wykys/BNEZ-projekt/README.md

# Projekt BNEZ zdroj dvou napětí

Uin = 18V ÷ 32V
Uout1 = 9V 2,4A
Uout2 = 4,5V 0,5A

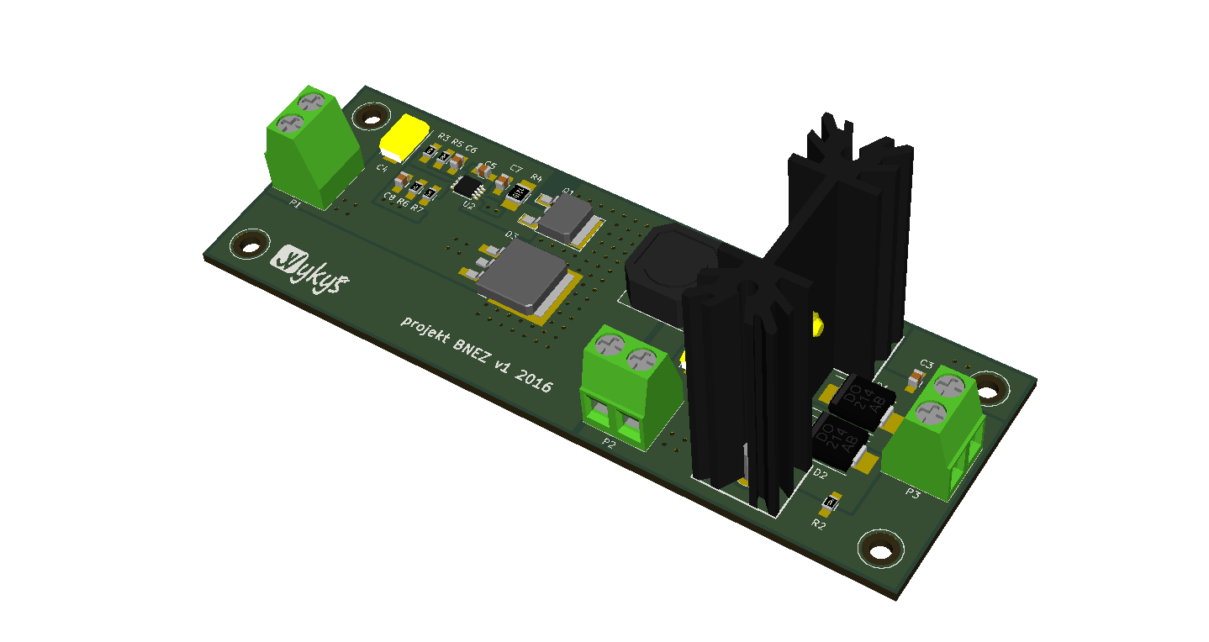
[picture p1: design/img/xvykyd06_zdroj_1.png]
demo
