wykys/BNEZ-projekt/dokumentace/realizace.tex

\clearpage
\section{Realizace napájecího zdroje}

\begin{figure}[H]
	\centering 	
	
	\caption{Plošný spoj vrstva součástek}	
\end{figure}

\begin{figure}[H]
	\centering 	
	
	\caption{Plošný spoj vrstva mědi}	
\end{figure}

\begin{figure}[H]
	\centering 	
	
	\caption{Osazovací výkres}	
\end{figure}

\begin{figure}[H]
	\centering 	
	
	\caption{Vrtací plán prokovené díry}	
\end{figure}

\begin{figure}[H]
	\centering 	
	
	\caption{Vrtací plán neprokovené díry}	
\end{figure}

\begin{table}[H]
	\caption{BOM rozpiska materiálu}
	\begin{figure}[H]
		\centering 	
		
	\end{figure}
\end{table}	

\newgeometry{left=1.25cm,bottom=1cm, top=2cm}
\begin{landscape}	
	\begin{figure}[h]
		\centering 	
		
		\caption{Schéma zapojení napájecího zdroje}	
	\end{figure}
\end{landscape}
\restoregeometry

\begin{figure}[H]
	\centering 	
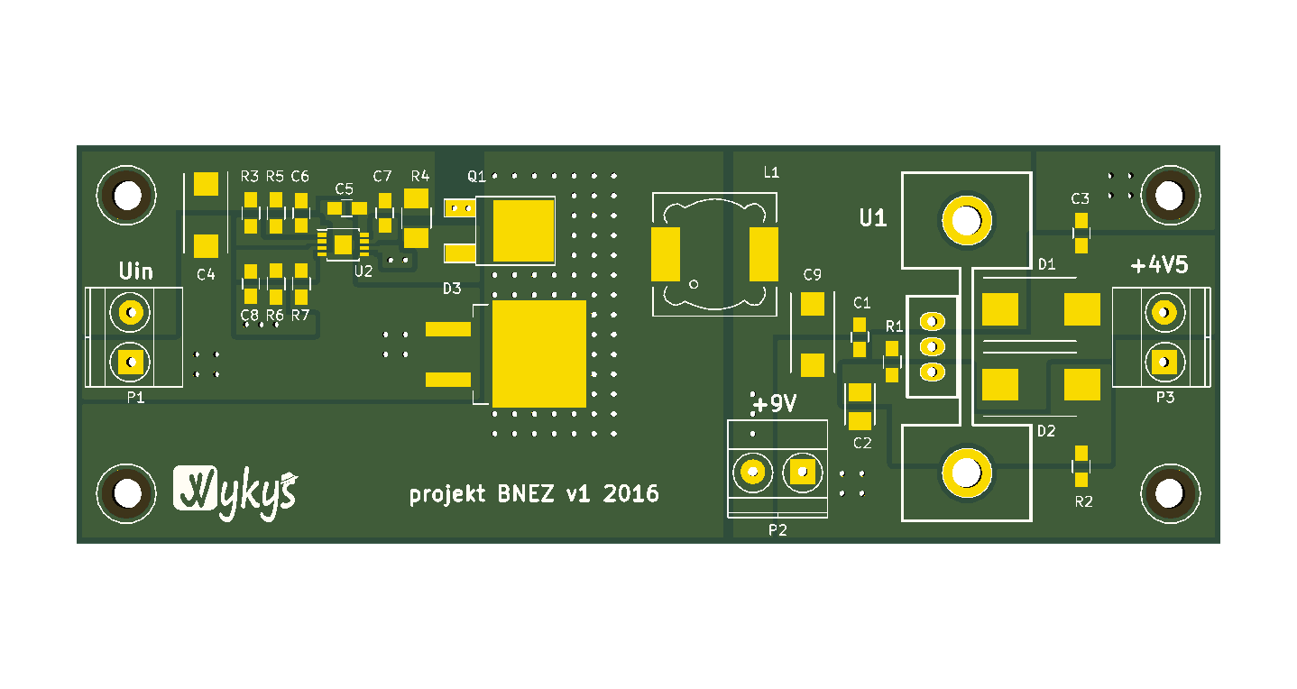
[picture p2: design/img/xvykyd06_zdroj_6.png]
	
	\caption{Plošný pohled na stranu součástek bez součástek}	
\end{figure}

\begin{figure}[H]
	\centering 	
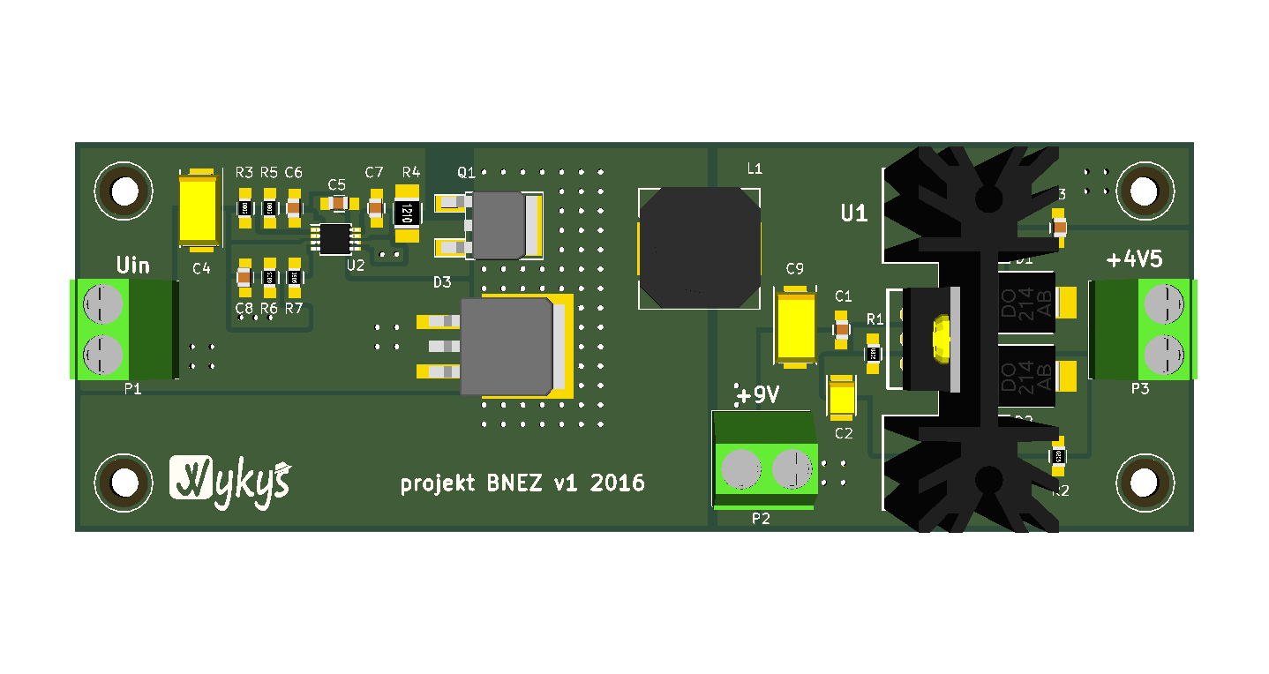
[picture p3: design/img/xvykyd06_zdroj_2.png]
	
	\caption{Plošný spoj pohled na stranu součástek}	
\end{figure}

\begin{figure}[H]
	\centering 	
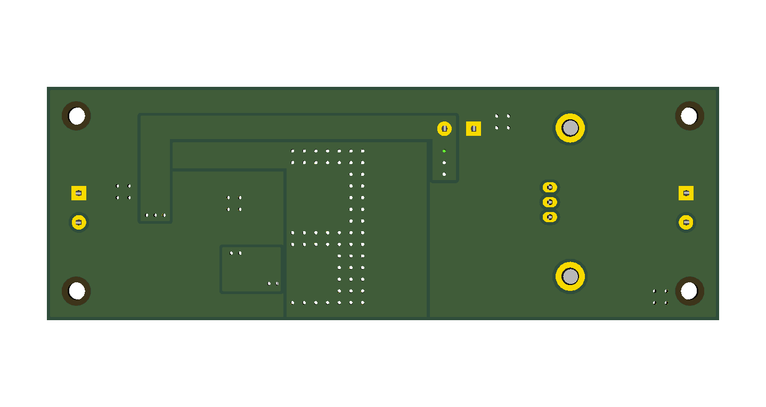
[picture p4: design/img/xvykyd06_zdroj_5.png]
	
	\caption{Plošný spoj pohled na stranu spojů}	
\end{figure}

\begin{figure}[H]
	\centering 	
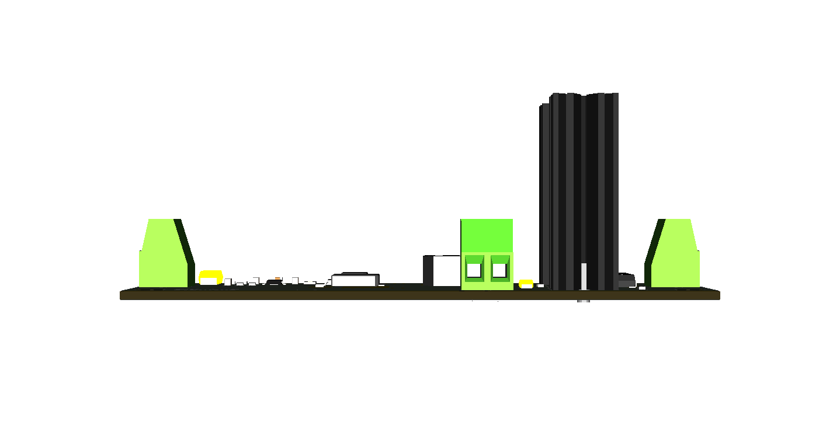
[picture p5: design/img/xvykyd06_zdroj_3.png]
	
	\caption{Napájecí zdroj pohled ze strany}	
\end{figure}

\begin{figure}[H]
	\centering 	
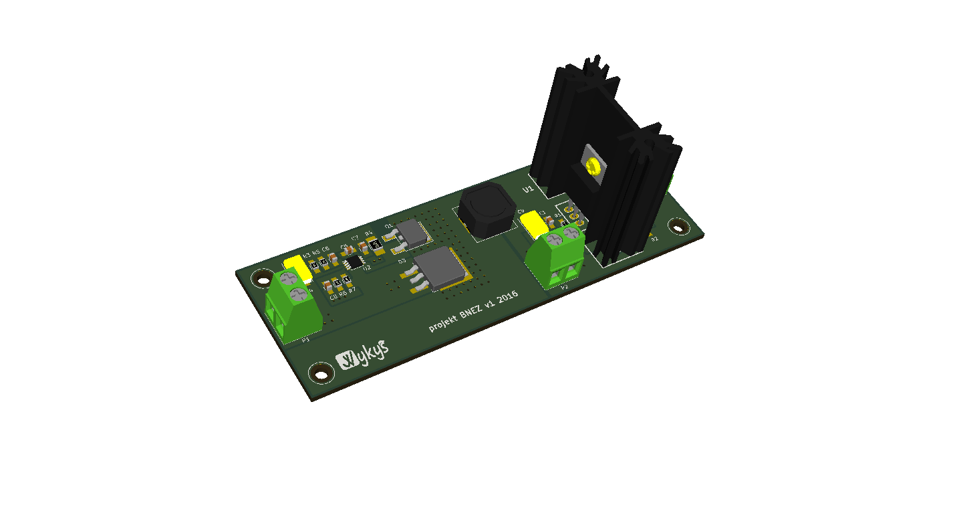
[picture p6: design/img/xvykyd06_zdroj_4.png]
	
	\caption{Napájecí zdroj pohled zepředu}	
\end{figure}

\begin{figure}[H]
	\centering 	
	
	\caption{Napájecí zdroj pohled zezadu}	
\end{figure}

Gerber soubory jsou generovány na POOL servis gatema.
