wykys/BNEZ-projekt/dokumentace/dokumentace.pdf

Jan Vykydal

Napajen ´ | í Elektronickych Za ´ | rˇízení

projekt zdroj dvou napetˇ í

FEKT UREL

List: | 1/11

## 1 Zadání

Uin | = (18 ÷ 32) V
Uout1 | = 9 V
Iout1 | = 2, 4 A
Uout2 | = 5 V
Iout2 | = 0, 5 A

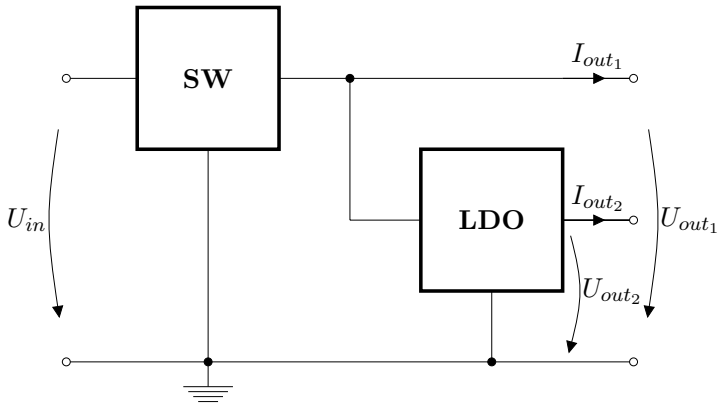
[picture p7: figure]
LDO; Iout2; Iout1; Uin; Uout1; Uout2

Obrázek 1: Blokové schéma zdroje

## 2 Vybrané integrované obvody

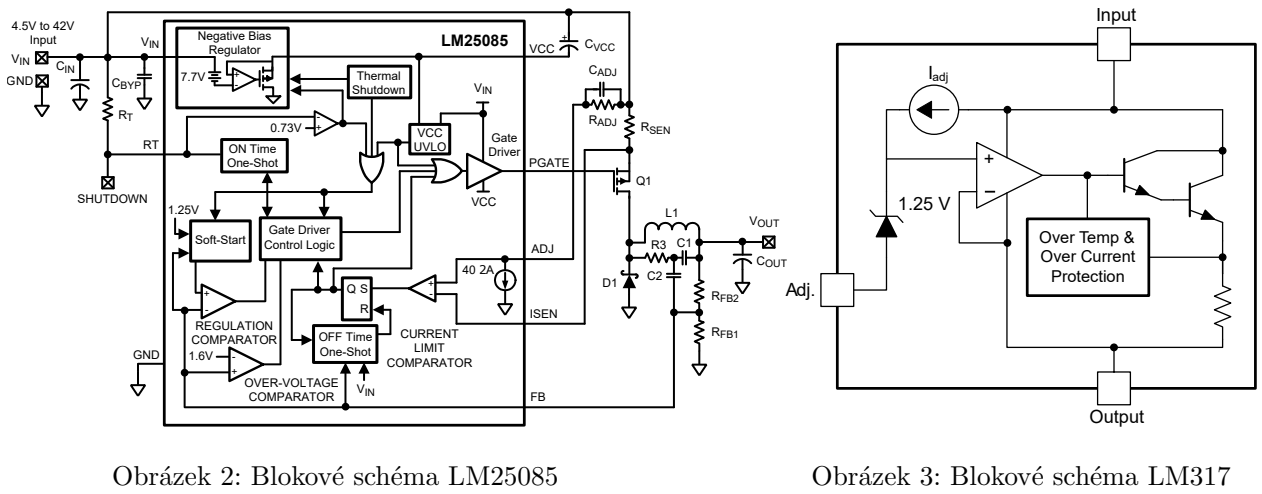
[picture p8: figure]
Negative Bias Regulator; Thermal Shutdown; ON Time One-Shot; Soft-Start; Gate Driver; Control Logic; VCC; UVLO; Gate; Driver; REGULATION COMPARATOR; OVER-VOLTAGE COMPARATOR; CURRENT LIMIT COMPARATOR; OFF Time One-Shot; PGATE; ISEN; GND; ADJ; 4.5V to 42V Input; VIN; SHUTDOWN; CVCC; CADJ; RADJ; RFB1; RFB2; CBYP; RSEN; VOUT; COUT; CIN; Obrázek 2: Blokové schéma LM25085; Over Temp & Over Current Protection; Input; Adj.; Output; Iadj; Obrázek 3: Blokové schéma LM317

LM25085 je regulátor PFET tranzistorů učený do spínaných snižujících měničů s vysokou účinností (buck). Naproti tomu LM317 je notoricky známý integrovaný obvod určený především jako lineární stabilizátor napětí, popřípadě drobnou úpravou okolních součástek a zapojení jako zdroj stabilního proudu.

## 3 Výpočty hodnot součástek pro LM25085 PFET kontrolér

VIN | = (18 ÷ 32) V
VIN | = 18 + 32
| 2 = 25 V
VOUT | = 9 V
IOUT | = Iout1 + Iout2
IOUT | = 2, 4 + 0, 5 .= 3 A
FSW | = 300 kHz
VRIP P LE | = 5 mVpp

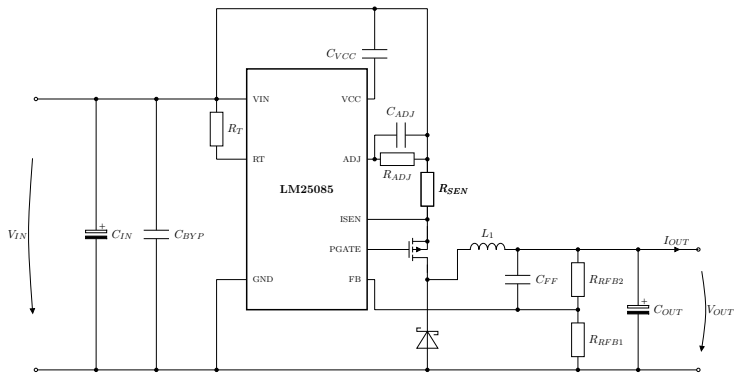
[picture p9: figure]
VIN; GND; VCC; ADJ; ISEN; PGATE; CIN; CBY P; CADJ; RADJ; RSEN; RRF B2; RRF B1; COUT; VOUT; IOUT

Obrázek 4: Snižující spínaný měnič

Výpočet střídy spínání:

D =

VOUT

VIN

=

tON

tON + tOF F

= tON · FS =

9
18

= 0, 5

9
25

= 0, 36

9
32

.= 0, 28

Výpočet doby otevření PFETu:

tON =

D
FS

=

VOUT

VIN · FS

9
18 · 300 · 10³

.= 1, 667 µs

9
25 · 300 · 10³

= 1, 2 µs

9
32 · 300 · 10³

= 937, 5 ns

Výpočet děliče zpětné vazby: RF B1 zvolím 1 kΩ

RF B2 =

VOUT
1, 25

− 1

- RF B1 =
9
1, 25

− 1

- 10³ = 6, 2 kΩ

Výpočet výstupního napětí:

VOUT = 1, 25 ·

RF B1 + RF B2

RF B1

= 1, 25 ·
1 +

RF B2

RF B1

= 1, 25 ·
1 +

6, 2
1
= 9 V

Výpočet kondenzátoru zpětné vazby:

CF F =

3 · Ton(max)

RBF1 · RBF2

RBF1 + RBF2

=

3 · 1, 667 · 10⁻⁶
1 · 10³
- 6, 2 · 10³
1 · 10³ + 6, 2 · 10³

= 5, 8 nF .= 6, 8 nF

Velikost rezistoru RT nastavuje spínací frekvenci: RT je v kΩ

RT =

VOUT · (VIN − 1, 56)
1, 45 · 10⁻⁷ · VIN · FS

−

tD · (VIN − 1, 56)
1, 45 · 10⁻⁷

− 1, 4

RT =

9 · (25 − 1, 56)
1, 45 · 10⁻⁷ · 25 · 300 · 10³

−

tD · (25 − 1, 56)
1, 45 · 10⁻⁷

− 1, 4 = 193, 016 kΩ .= 180 kΩ

Výpočet vyhlazovací cívky:

L1 =

tON(min)

·

VIN(max) − VOUT

0, 2 · IOUT

=

937, 5 · 10⁻⁹
- (32 − 9)
0, 2 · 3

.= 36 µH

Vzhledem k toleranci nominální hodnoty vyráběných cívek zvolím cívku 47 µH abych měl rezervu, pokud bude hodnota cívka v dolní části tolerančního pásma.

Výpočet vyhlazovacího kondenzátoru:

COUT =

0, 2 · IOUT

8 · FS · VRIP P LE

=

0, 2 · 3
8 · 300 · 10³ · 5 · 10⁻³

= 50 µF .= 68 µF

Vzhledem k tomu, že tento kondenzátor je na výstupu spínaného měniče kde se výstupní napětí pohybuje okolo 9 V , tak tento kondenzátor by měl být dimenzován minimálně na 16 V pro jistotu na 20 V .

Výpočet vstupního kondenzátoru:

CIN + CBY P =

IOUT · tON(max)
∆V | =

3 · 1, 667 · 10⁻⁶

0, 5

.= 10 µF

CBY P zvolím podle doporučení datasheetu jako 1 µF a CIN zvolím jako 10 µF na 50 V , protože vstupní napětí může být až 32 V .

Výpočet zvlnění proudu:

∆I =

tON(min)

·

VIN(max) − VOUT

L1

=

937, 5 · 10⁻⁹
- (32 − 9)
47 · 10⁻⁶

.= 459 mA

Velikost minimální hodnoty proudové limitace:

ICL(min) = IOUT +

∆I
2

= 3 +

0, 459
2

.= 3, 25 A

Výpočet minimálního proudového limitu se započítanou chybou offsetu komparátoru:

ICL(min)offset

= ICL(min) +

9 · 10⁻³

RSEN

= 3, 25 +

9 · 10⁻³
10 · 10⁻³

= 4, 15 A

Výpočet rezistoru RADJ :

RADJ =

ICL(min)offset

- RSEN

IADJ(min)

=

4, 15 · 10 · 10⁻³
32 · 10⁻⁶

= 1297 Ω

.= 1, 5 kΩ

CADJ = 1 nF hodnota podle doporučení v datasheetu, filtruje šum s ADJ pinu, zabraňuje nechtěnému sepnutí komparátoru.

Velikost rezistoru RSEN výrobce doporučuje 10 mΩ, výkonová ztráta na rezistoru je:

PRSEN = I

2
CL(min)
- RSEN = 3, 25²
- 10 · 10⁻³ .= 106 mW

Podle toho je důležité zvolit pouzdro, které snese takovéto zatížení. Vypočítané zatížení by snesl rezistor v pouzdru 0805, který vydrží 125 mW či pouzdro 1206 které vydrží do 250 mW, pro jistotu, ale volím pouzdro 1210, které vydrží výkon až 500 mW tím zajistím že součástka nebude na pokraji svých možností a bude mít dostatečnou životnost.

Hodnota kondenzátoru CV CC je dle doporučení datasheetu 470 nF.

## 4 Výpočty hodnot součástek pro lineární stabilizátor s LM317

Vi | = 9 V
Vo | = 4, 5 V
Io | = 0, 5 A
VREF | = 1, 25 V
IADJ | = 50 µA

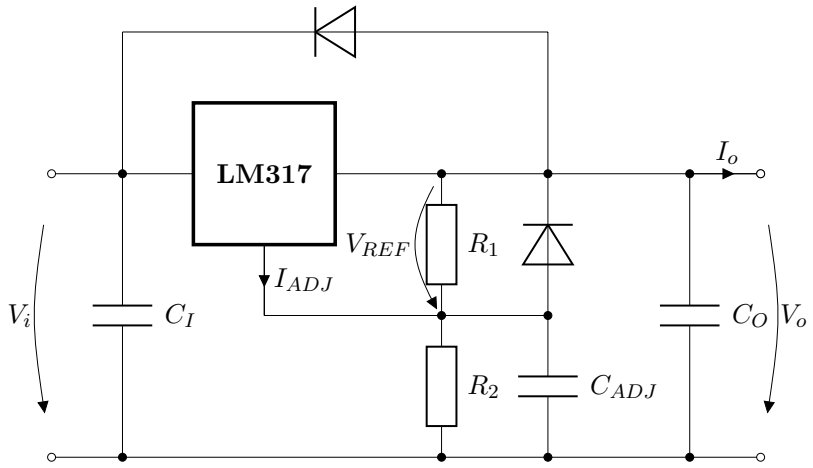
[picture p10: figure]
IADJ; VREF; CADJ

Obrázek 5: Lineární stabilizátor

Výpočet zpětnovazebního děliče:

R2 =

Vo − VREF

VREF
R1

+ IADJ

=

4, 5 − 1, 25
1, 25
R1

+ 50 · 10⁻⁶

K výpočtu nejpřesnější kombinace rezistorů R1 a R2 jsem napsal skript LM317.py, který vypočítá pro řady E3 ÷ E192 nejvhodnější kombinace rezistorů. Výsledek skriptu pro Vo = 4, 5 V je uveden v tabulce.

Tabulka č. 1: Hodnoty zpětnovazebného děliče pro LM317

řada | R [Ω] | R [Ω] | Vo [V ]
E3 | 100 | 220 | 4,0110
E6 | 680 | 1500 | 4,0824
E12 | 470 | 1200 | 4,5015
E24 | 510 | 1300 | 4,5013
E48 | 953 | 2370 | 4,4771
E96 | 562 | 1430 | 4,5021
E192 | 229 | 590 | 4,5000

Výpočet výstupního napětí:

Vo = VREF ·

1 +

R2
R1
+ IADJ · R2 = 1, 25 ·
1 +

590

229
+ 50 · 10⁻⁶
- 590 .= 4, 5 V

Vstupní a výstupní kondenzátor mají hodnotu podle doporučení datasheetu a to: Ci = 100 nF a Co = 1 µF. Na Co je možné ještě paralelně přiletovat CBY P ASS v pouzdru 0805 pro přemostění vysokofrekvenčního rušení. Kondenzátor pro stabilizaci napět’ové reference má také hodnotu dle doporučení výrobce CADJ = 10 µF.

## 5 Výpočty chlazení a výkonových ztrát

Výpočet výkonové ztráty na LM317:

PLM317 = (Vi − Vo) · Io = (9 − 4, 5) · 0, 5 = 2, 25 W

Výpočet výkonové ztráty na schottkyho diodě:

PD = VF · IOUT ·

1 − D(min)

= 3 · 0, 455 · (1 − 0, 28) .= 962 mW

Výpočet výkonové ztráty na PFETu:

PP F ET = VIN(max)

- (QG · FS + IIN ) = 32 · (24 · 10⁻⁹
- 300 · 10³ + 1, 3 · 10⁻³
) = 272 mW

Výpočet celkového tepelného odporu chlazení LM317:

Rthsys(LM317) =

ϑj(max) − ϑa

PLM317

=

150 − 80
2, 25

.= 32 KW⁻¹

Výpočet celkového tepelného odporu chlazení schottkyho diody:

Rthsys(D) =

ϑj(max) − ϑa

PD

=

150 − 80
0, 962

.= 73 KW⁻¹

Výpočet celkového tepelného odporu chlazení PFETu:

Rthsys(P F ET ) =

ϑj(max) − ϑa

PP F ET

=

175 − 80
0, 272

.= 345 KW⁻¹

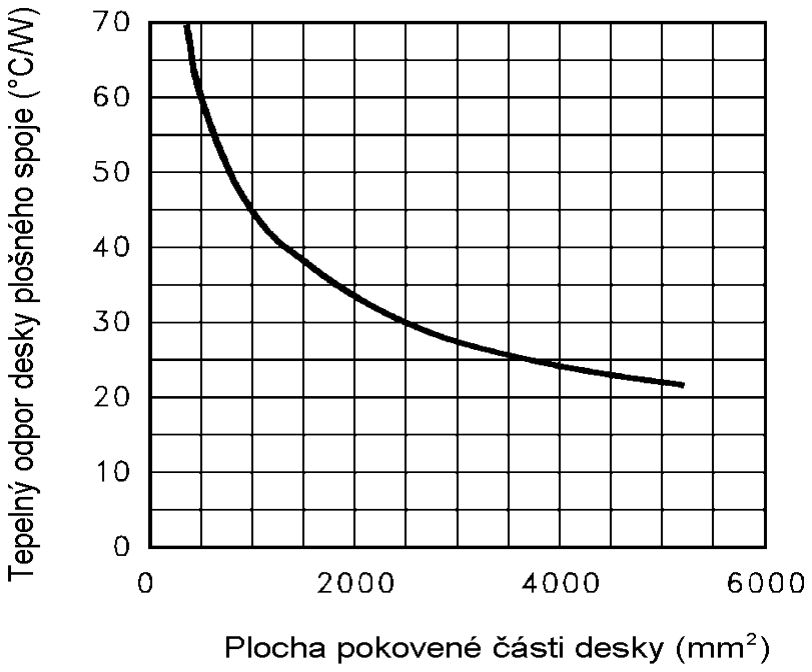
[picture p11: figure]

Obrázek 6: Graf závislosti tepelného odporu plošného spoje na jeho ploše

Z grafů vyplývá, že shottkyho diodu a PFET nebude problém uchladit plošným spojem, pro LM317 ale vychází plocha mědi na můj vkus příliš veliká cca 7 cm·7 cm a tak zvolím klasické chlazení hliníkovým profilem. Vybral jsem chladič s tepelným odporem 11 KW⁻¹
, takže teplota křemíkového čipu LM317 by měla být nižší, než teplota maximální na kterou jsem počítal celkový tepelný odpor.

## 6 Realizace napájecího zdroje

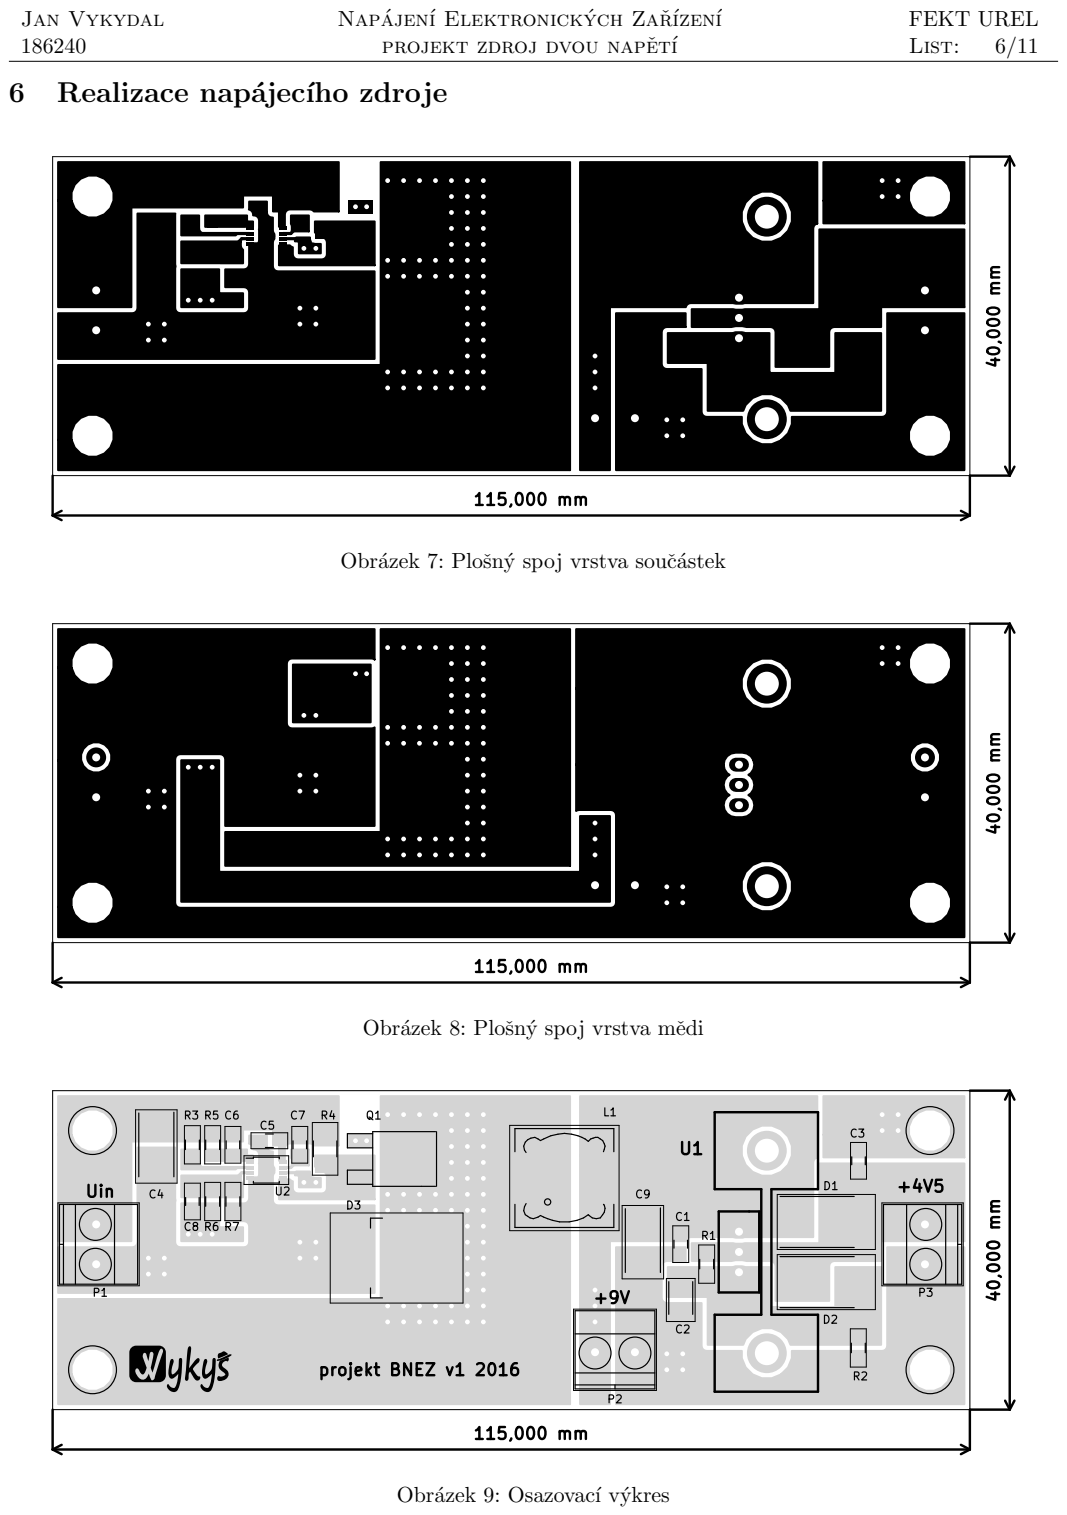
[picture p12: page 6]

Obrázek 7: Plošný spoj vrstva součástek

Obrázek 8: Plošný spoj vrstva mědi

Obrázek 9: Osazovací výkres

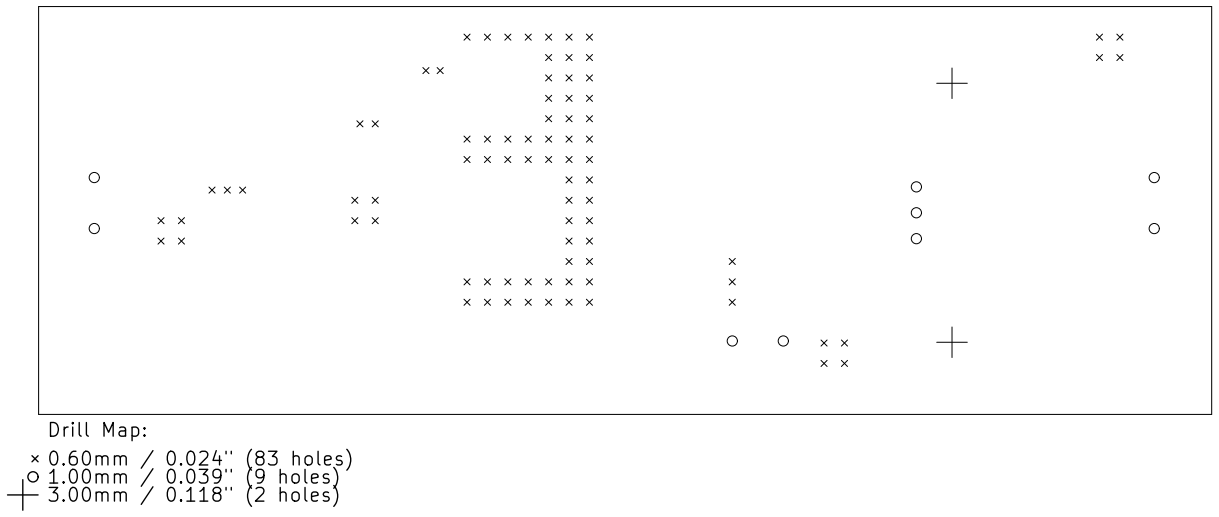
[picture p13: figure]

Obrázek 10: Vrtací plán prokovené díry

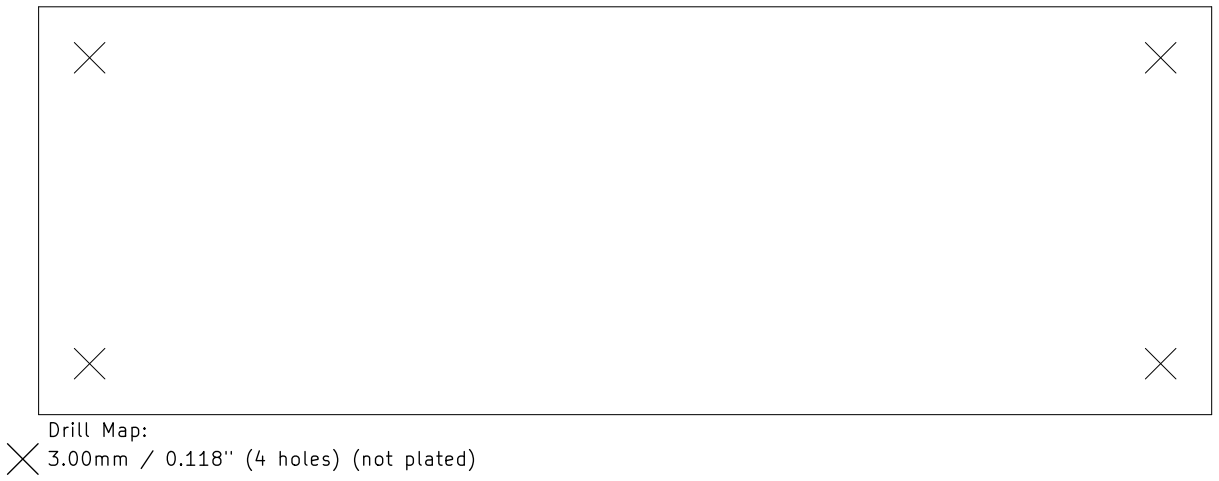
[picture p14: figure]

Obrázek 11: Vrtací plán neprokovené díry

Tabulka č. 2: BOM rozpiska materiálu

ref | hodnota | footprint | cena | link | datasheet
C1 | 100n | 0805 | 1,0000 | standatd 10%
C2 | 10u/20V | Tantal_SizeB | 12,4510 | http://cz.farnell.com/kemet/t491b106k020at/cap-tant-10uf-20v-case-b/dp/1457437 | http://www.farnell.com/datasheets/2121504.pdf
C3 | 1u | 0805 | 20,0000 | standatd 10%
C4 | 10u/50V | Tantal_SizeD | 62,3920 | http://cz.farnell.com/kemet/t491d106k050at/cap-tant-10uf-50v-case-d/dp/1692396RL | http://www.farnell.com/datasheets/2122222.pdf
C5 | 1u | 0805 | 20,0000 | standatd 10%
C6 | 1n | 0805 | 1,0000 | standatd 10%
C7 | 470n | 0805 | 1,0000 | standatd 10%
C8 | 6n8 | 0805 | 1,0000 | standatd 10%
C9 | 68u/20V | Tantal_SizeD | 40,8580 | http://cz.farnell.com/kemet/t491d686k020at/cap-tant-68uf-20v-case-d/dp/2283592RL | http://www.farnell.com/datasheets/2121528.pdf
D1 | BYG10D-E3/TR | DO-214AC | 6,4320 | http://cz.farnell.com/vishay/byg10d-e3-tr/diode-standard-1-5-a-do-214/dp/1612314 | http://www.farnell.com/datasheets/2046084.pdf
D2 | BYG10D-E3/TR | DO-214AC | 6,4320 | http://cz.farnell.com/vishay/byg10d-e3-tr/diode-standard-1-5-a-do-214/dp/1612314 | http://www.farnell.com/datasheets/2046084.pdf
D3 | STPS20M100S | TO-263 | 64,8760 | http://cz.farnell.com/stmicroelectronics/stps20m100sg-tr/diode-schottky-20a-100v-d2pak/dp/2325907 | http://www.farnell.com/datasheets/1716357.pdf
L1 | 47u | Choke_SMD_12x12mm_h6mm | 57,4230 | http://cz.farnell.com/bourns/srp1265a-470m/inductor-shielded-47uh-20-6-5a/dp/2434080 | http://www.farnell.com/datasheets/2059704.pdf
P1 | MA522-500M02 | TerminalBlock_Pheonix_MKDS1.5-2pol | 7,0440 | http://cz.farnell.com/multicomp/ma522-500m02/terminal-block-wire-to-brd-2pos/dp/2396252 | http://www.farnell.com/datasheets/2059704.pdf
P2 | MA522-500M02 | TerminalBlock_Pheonix_MKDS1.5-2pol | 7,0440 | http://cz.farnell.com/multicomp/ma522-500m02/terminal-block-wire-to-brd-2pos/dp/2396252 | http://www.farnell.com/datasheets/1706879.pdf
P3 | MA522-500M02 | TerminalBlock_Pheonix_MKDS1.5-2pol | 7,0440 | http://cz.farnell.com/multicomp/ma522-500m02/terminal-block-wire-to-brd-2pos/dp/2396252 | http://www.farnell.com/datasheets/1706879.pdf
Q1 | FDD5614P | TO-252 | 12,9200 | http://cz.farnell.com/fairchild-semiconductor/fdd5614p/mosfet-p-60v-15a-d-pak/dp/9846131 | http://www.farnell.com/datasheets/1706879.pdf
R1 | 510R | 0805 | 2,0000 | standatd 1%
R2 | 1k3 | 0805 | 2,0000 | standatd 1%
R3 | 180k | 0805 | 2,0000 | standatd 1%
R4 | R01 | 1210 | 8,0000 | standatd 1%
R5 | 1k5 | 0805 | 2,0000 | standatd 1%
R6 | 6k2 | 0805 | 2,0000 | standatd 1%
R7 | 1k | 0805 | 2,0000 | standatd 1%
U1 | LM317KCS | TO-220 | 16,0120 | http://cz.farnell.com/texas-instruments/lm317kcs/v-reg-37vin-1-5a-0-1-adj- 3to220/dp/2144307?ost=LM317KChttp://www.farnell.com/datasheets/1994326.pdf
U2 | LM25085MYE | MSOP | 60,7350 | http://cz.farnell.com/texas-instruments/lm25085mye/ic-sw-buck-controller-42v-8msoic/dp/1689555 | http://cz.farnell.com/texas-instruments/lm25085mye/ic-sw-buck-controller-42v-8msoic/dp/1689555
| chladič | na TO-220 | 48,0360 | http://cz.farnell.com/fischer-elektronik/sk-104-38-1-sts/heatsink-to220/dp/1892327 | http://www.farnell.com/datasheets/1332085.pdf
Celková cena: | 473,6990

# R4 R01 R³ 180k 470n C7 R5

# VCC GND

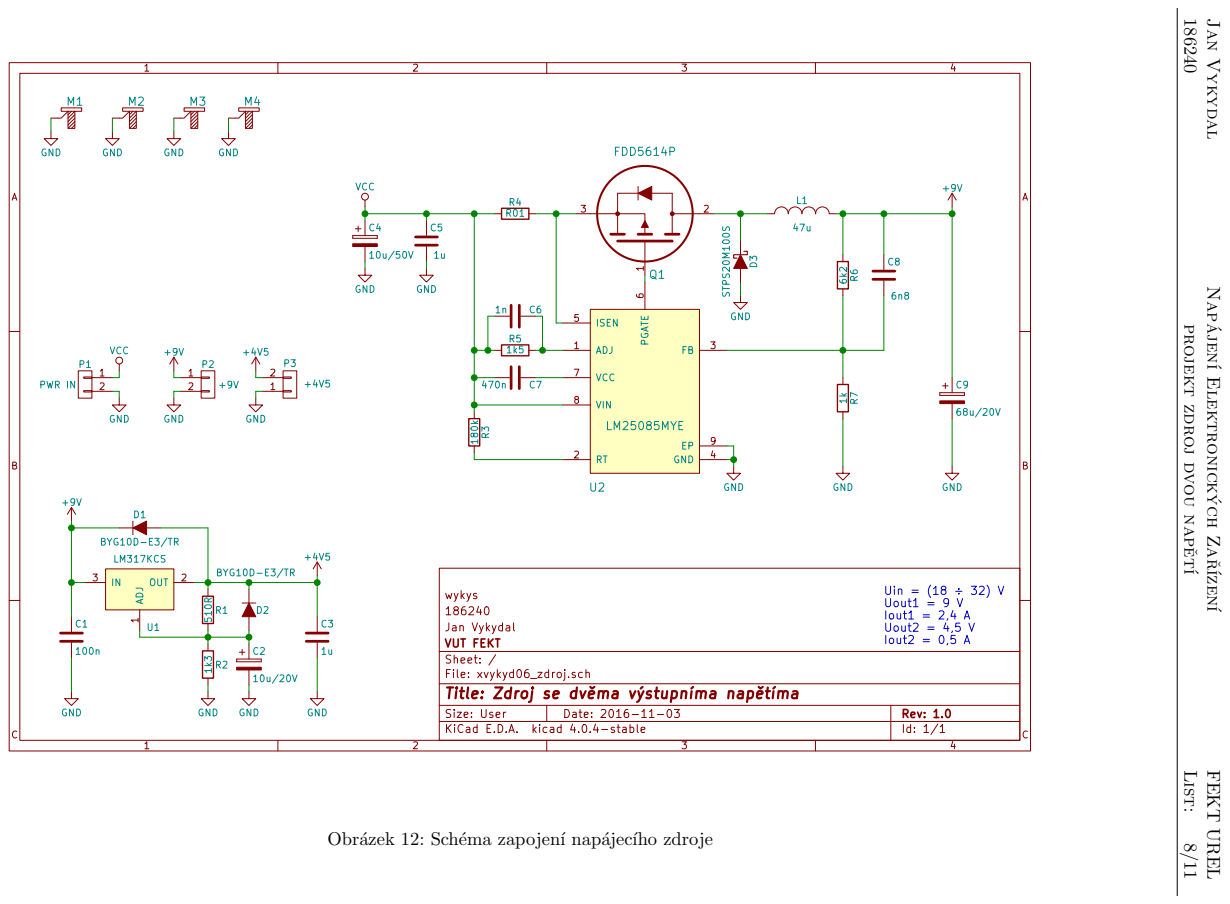
[picture p15: page 8]

Jan Vykydal Napajen ´ ı Elektronick ´ ych Za ´ rǐzen ´ í

projekt zdroj dvou napetˇ í List:

File: xvykyd06_zdroj.sch Sheet: / VUT FEKT

Id: 1/1 Title: Zdroj se dvma výstupníma naptíma

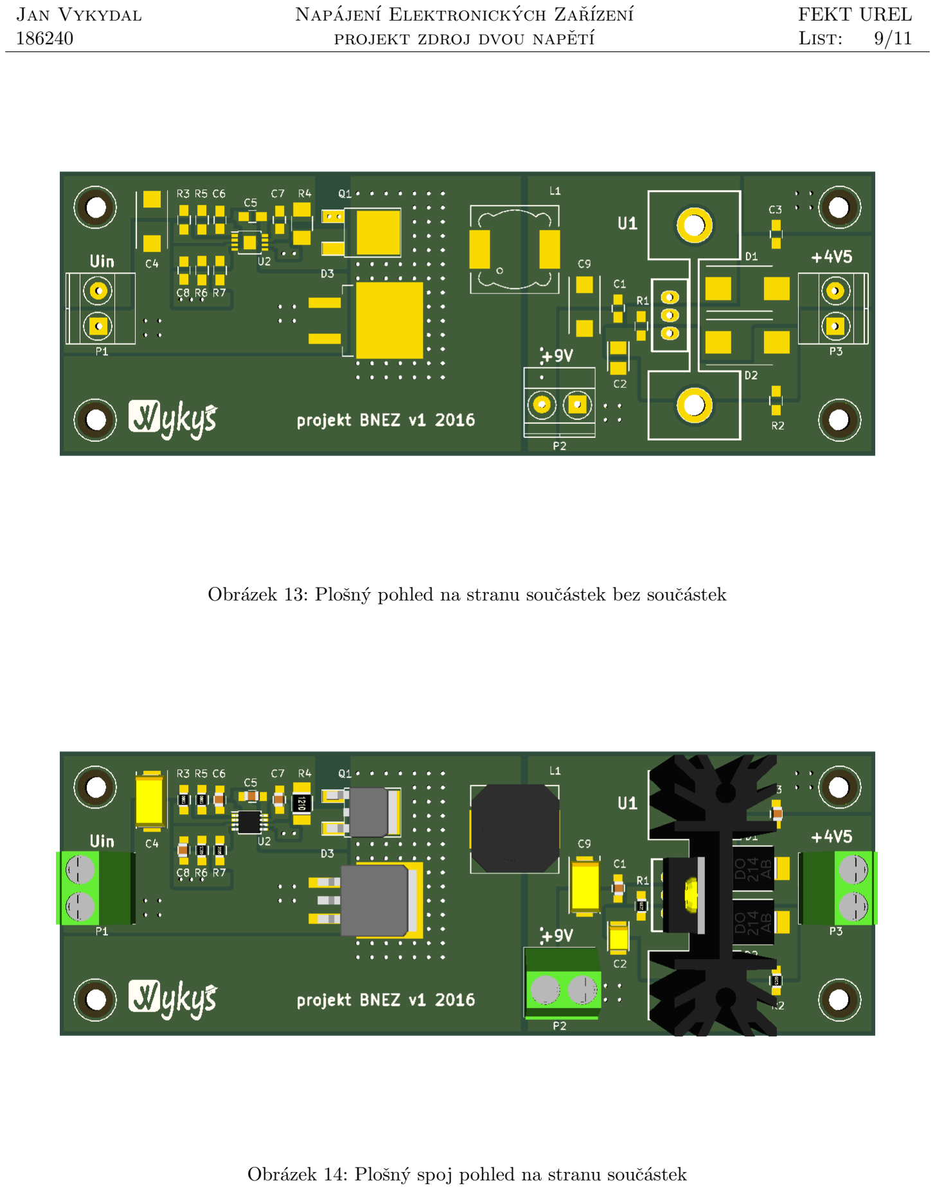
[picture p16: page 9]

Obrázek 13: Plošný pohled na stranu součástek bez součástek

Obrázek 14: Plošný spoj pohled na stranu součástek

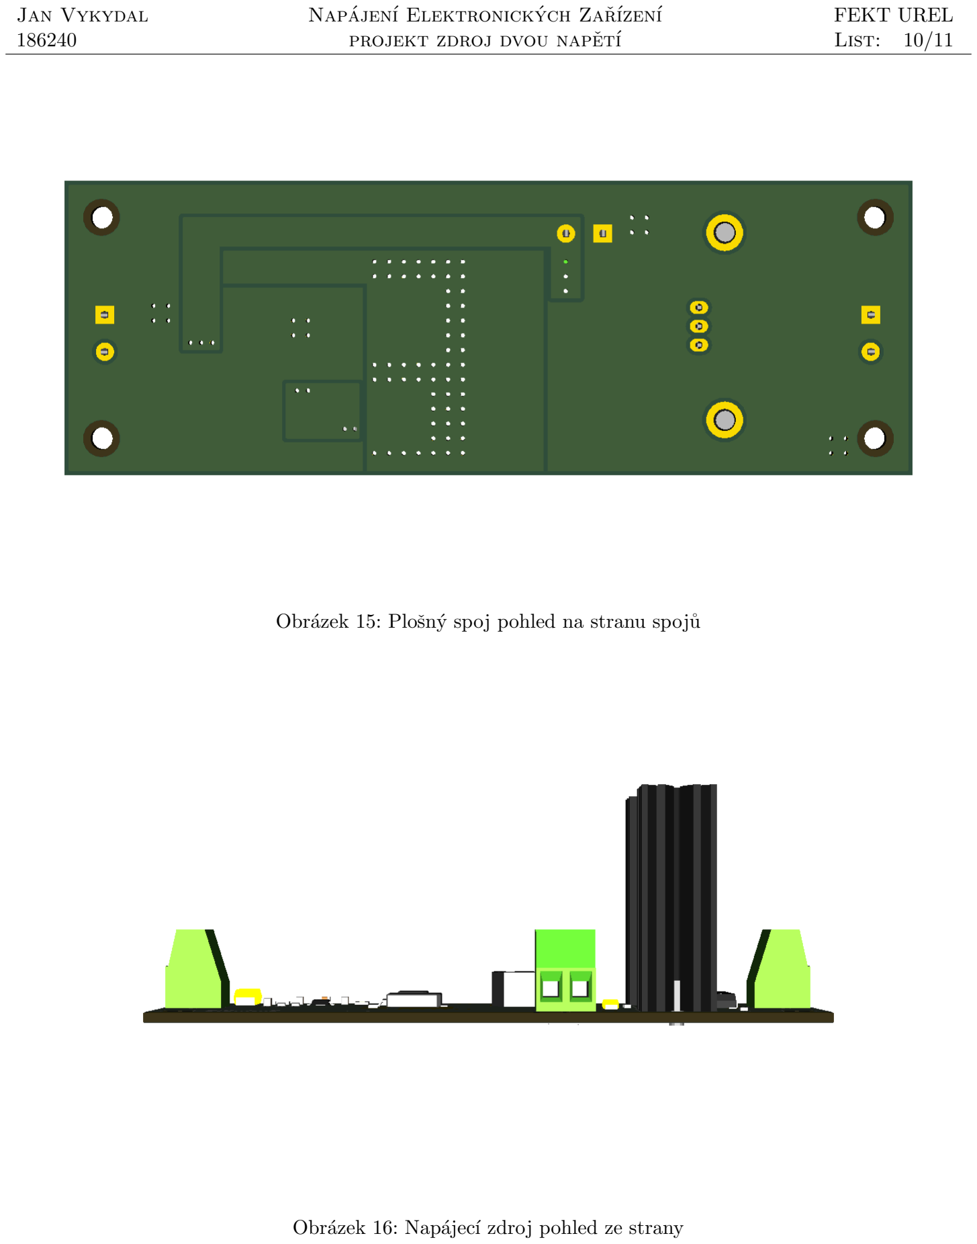
[picture p17: page 10]

Obrázek 15: Plošný spoj pohled na stranu spojů

Obrázek 16: Napájecí zdroj pohled ze strany

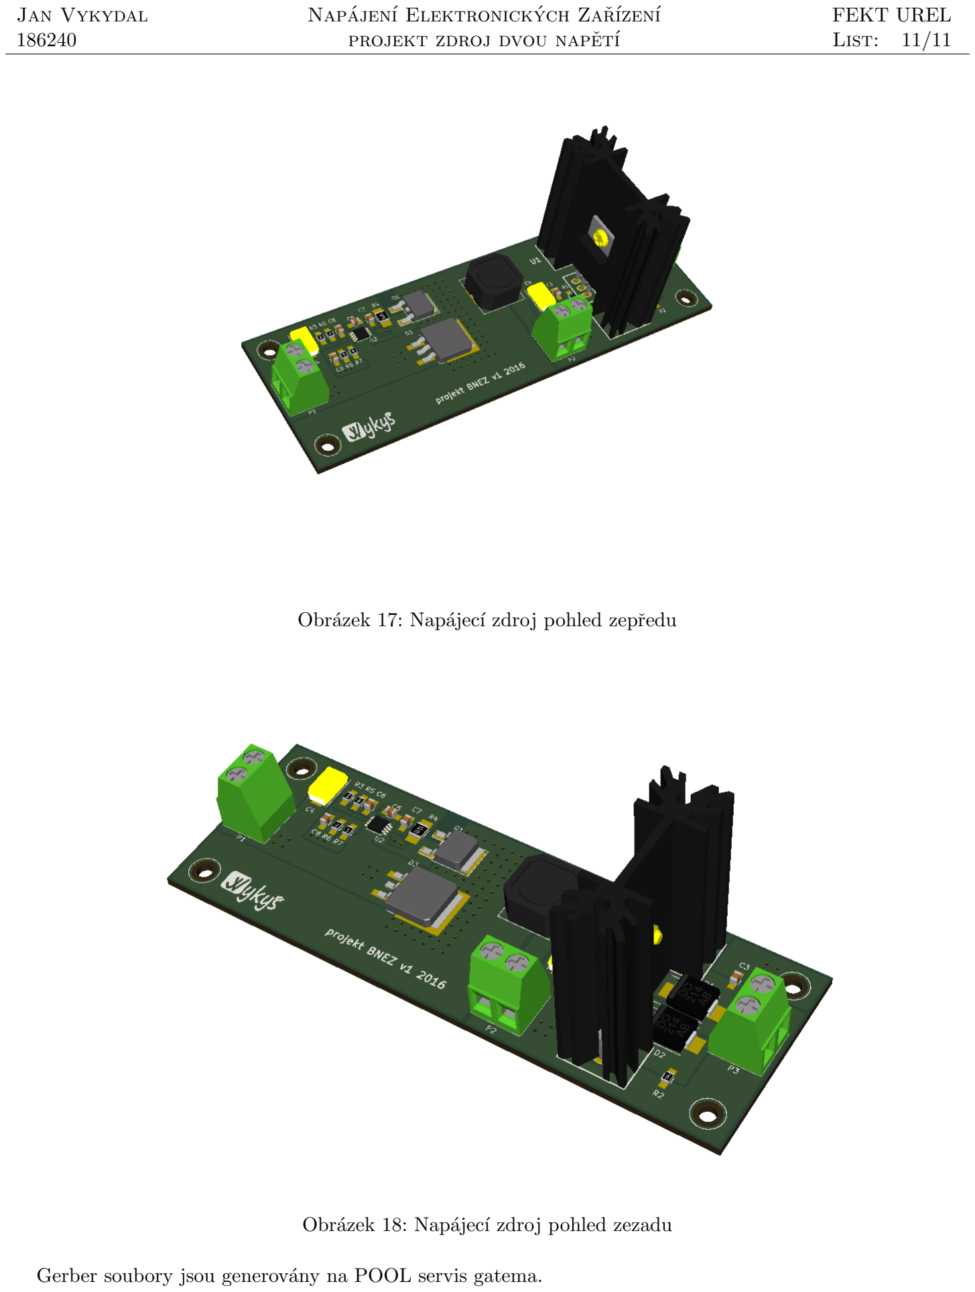
[picture p18: page 11]

Obrázek 17: Napájecí zdroj pohled zepředu

Obrázek 18: Napájecí zdroj pohled zezadu

Gerber soubory jsou generovány na POOL servis gatema.
