wykys/BNEZ-projekt/dokumentace/zadani.tex

\section{Zadání}

\begin{table}[H]
	\begin{center}

		\begin{tabular}{c | c}
			\begin{minipage}{0.3\textwidth}
				\begin{eqnarray}
					U_{in} &=& (18 \div 32)~V \nonumber\\\nonumber\\
					U_{out_1} &=& 9~V \nonumber\\
					I_{out_1} &=& 2,4~A \nonumber\\\nonumber\\
					U_{out_2} &=& 5~V \nonumber\\
					I_{out_2} &=& 0,5~A \nonumber
				\end{eqnarray}
			\end{minipage}

	&		
				
			\begin{minipage}{0.6\textwidth}
				\begin{figure}[H]
					\begin{center}
						\begin{circuitikz}
							%\draw[help lines, thick] (0,0) grid (10,8);	
							\draw (2,4) node[ic3pin] (ic1) {\textbf{SW}};
							\draw (6,2) node[ic3pin] (ic2) {\textbf{LDO}};			
							
							%(0,0) node[anchor=east] {Vstup}			
							\draw (0,0) to[short, o-o] (8,0);
							\draw (0,4) to[short, o-] (1,4);			
							\draw (3,4) to[short, -] (7,4);
							\draw (7,2) to[short, -o, i=$I_{out_2}$] (8,2);			
							\draw (4,4) to[short, *-] (4,2) to[short] (5,2);
							\draw (2,3) to[short, -*] (2,0);
							\draw (6,1) to[short, -*] (6,0);
							
							\draw (2,0) node[ground] {};
							
							\draw (7,4) to[short, -o, i=$I_{out_1}$] (8,4);
							\draw (0,4) to[open, v=$U_{in}$] (0,0);
							\draw (8.1,0) to[open, v<=$U_{out_1}$] (8.1,4);
							\draw (7,0) to[open, v<=$U_{out_2}$] (7,2);			

						\end{circuitikz}
					\end{center}
					\caption{Blokové schéma zdroje}
				\end{figure}
			\end{minipage}
		\end{tabular}
	\end{center}	
\end{table}
