wykys/BNEZ-projekt/dokumentace/img/DPS_odpor.pdf

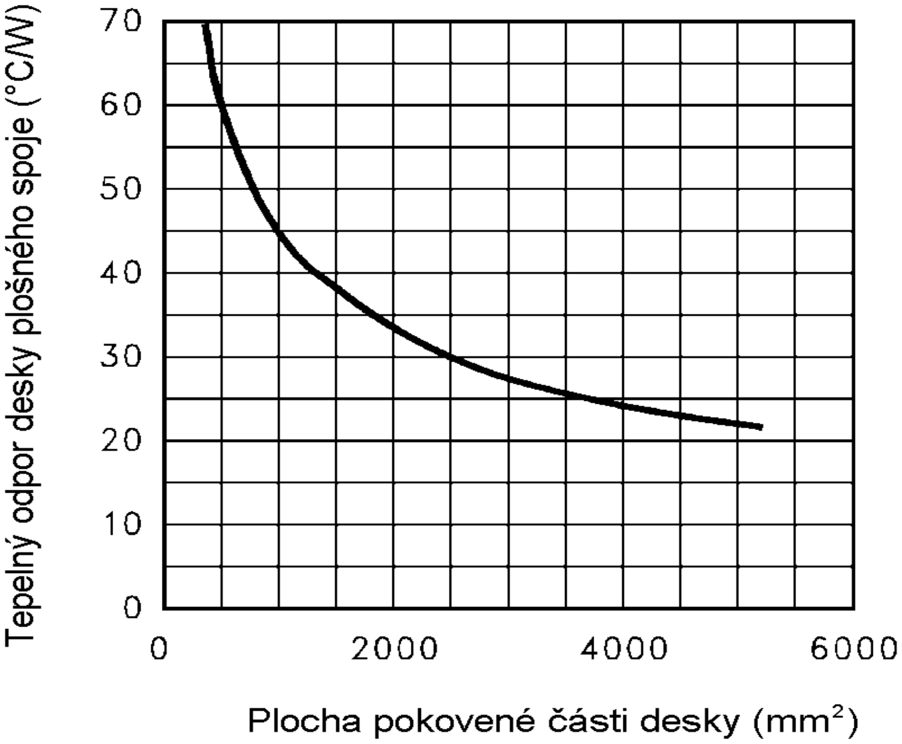
[picture p19: page 1]
