wykys/BNEZ-projekt/webench_design_4837964_17_571227985.pdf

## WEBENCH ® Design Report

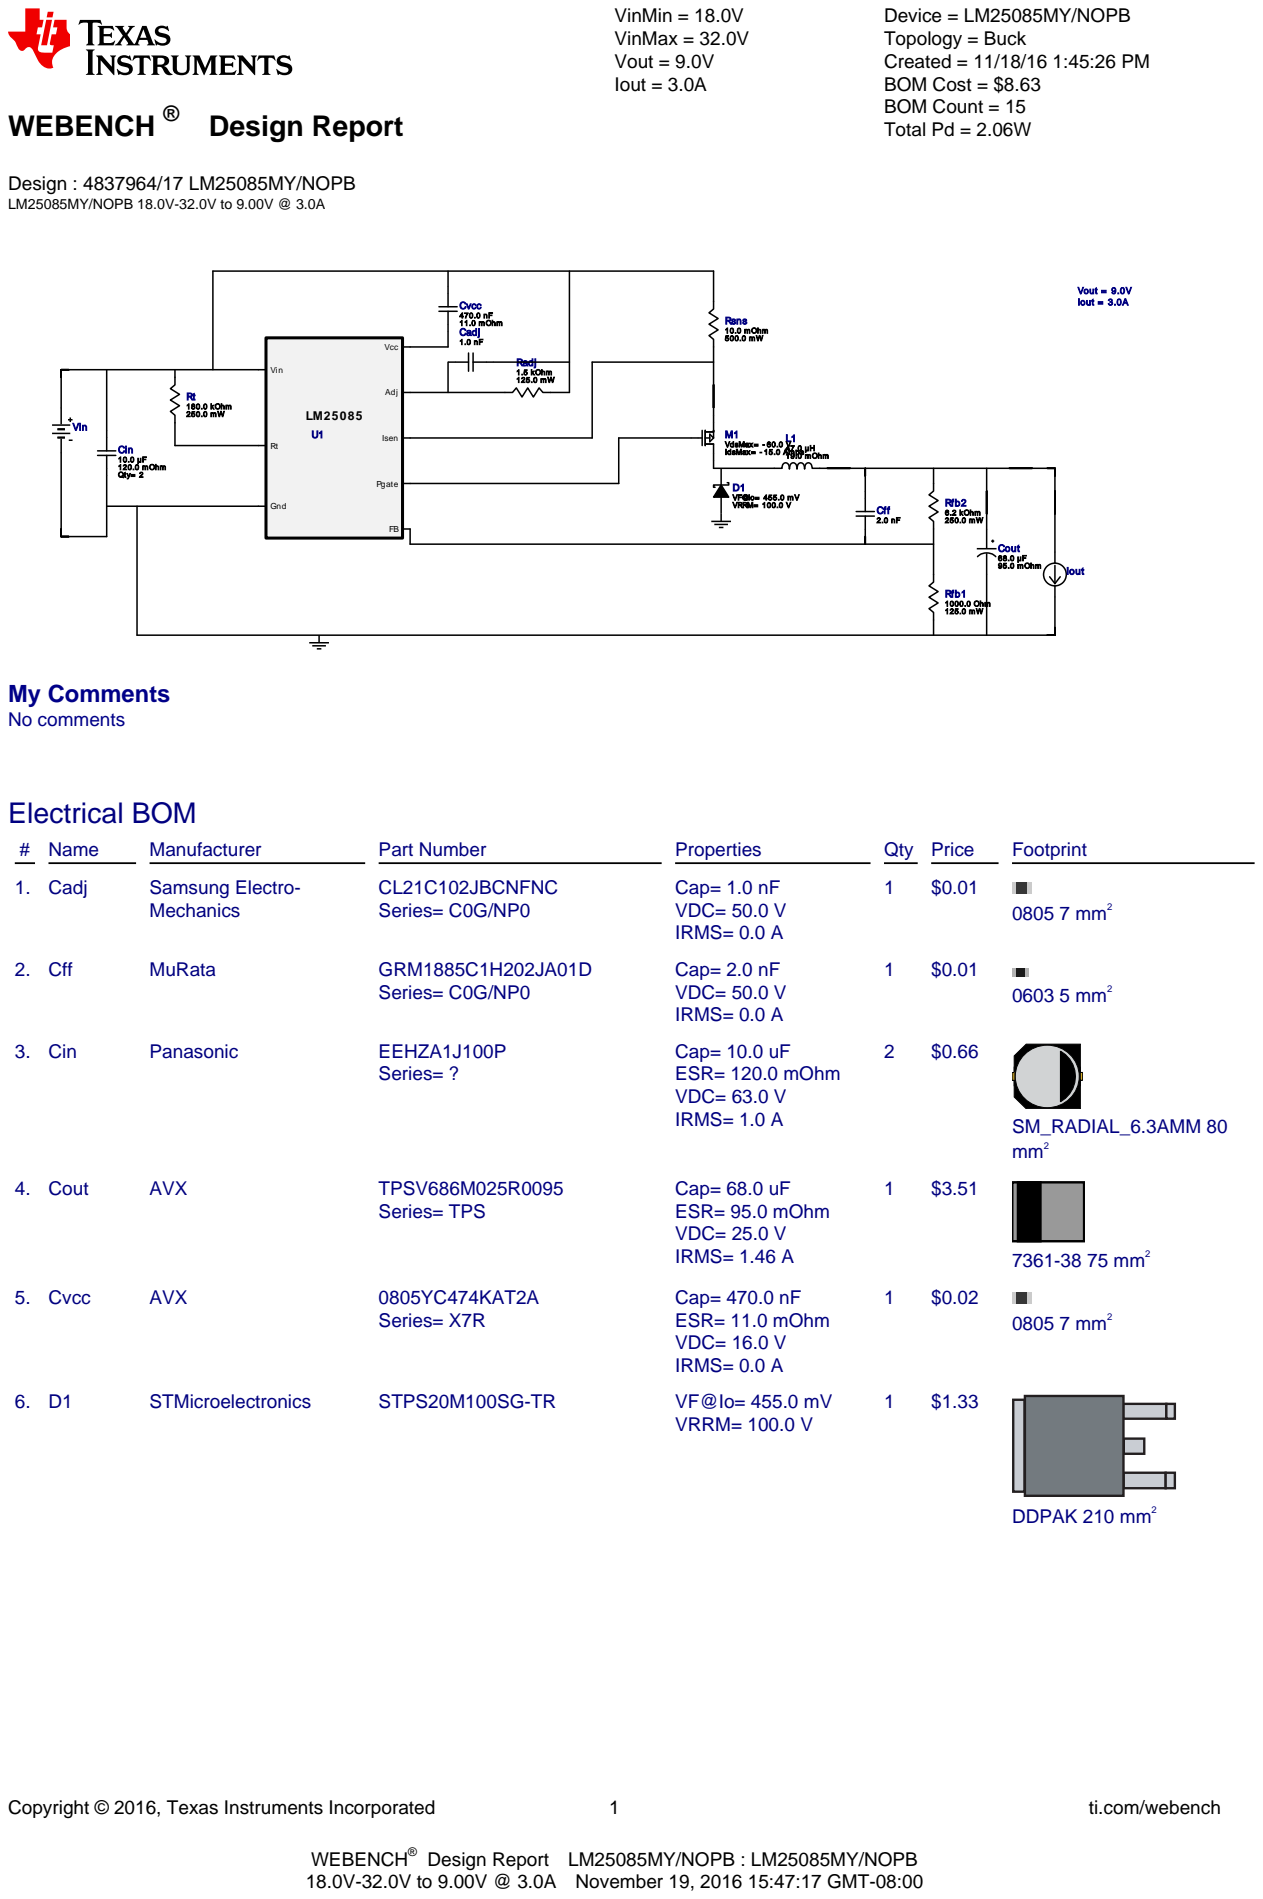
[picture p20: page 1]
Copyright © 2016, Texas Instruments Incorporated; ti.com/webench; Design : 4837964/17 LM25085MY/NOPB LM25085MY/NOPB 18.0V-32.0V to 9.00V @ 3.0A; VinMin = 18.0V VinMax = 32.0V Vout = 9.0V Iout = 3.0A; Device = LM25085MY/NOPB Topology = Buck Created = 11/18/16 1:45:26 PM BOM Cost = $8.63 BOM Count = 15 Total Pd = 2.06W; Cff 2.0 nF; Cadj 1.0 nF; Cin 10.0 µF 120.0 mOhm Qty= 2; Cout 68.0 µF; 95.0 mOhm; Cvcc 470.0 nF 11.0 mOhm; D1 VF@Io= 455.0 mV VRRM= 100.0 V; L1 47.0 µH 19.0 mOhm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

WEBENCH®
18.0V-32.0V to 9.00V @ 3.0A November 19, 2016 15:47:17 GMT-08:00

Design Report LM25085MY/NOPB : LM25085MY/NOPB

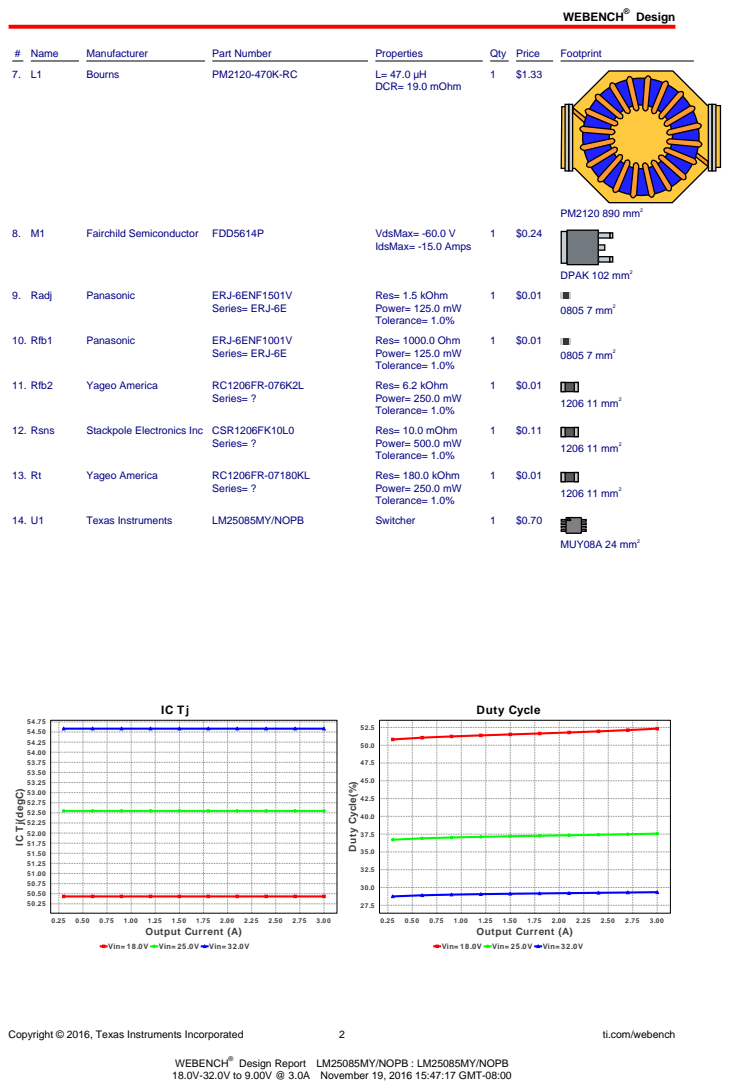
[picture p21: page 2]
Design; Copyright © 2016, Texas Instruments Incorporated; ti.com/webench; # Name; Manufacturer; Part Number; Properties; Qty Price; Footprint; Bourns; DCR= 19.0 mOhm; PM2120 890 mm²; Fairchild Semiconductor FDD5614P; VdsMax= -60.0 V; IdsMax= -15.0 Amps; DPAK 102 mm²; 9. Radj; Panasonic; ERJ-6ENF1501V; Series= ERJ-6E; Res= 1.5 kOhm Power= 125.0 mW Tolerance= 1.0%; 0805 7 mm²; 10. Rfb1; ERJ-6ENF1001V; Res= 1000.0 Ohm Power= 125.0 mW Tolerance= 1.0%; 11. Rfb2; Yageo America; Series= ?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

IC Tj(degC)

Vin= 18.0V Vin= 25.0V Vin= 32.0V

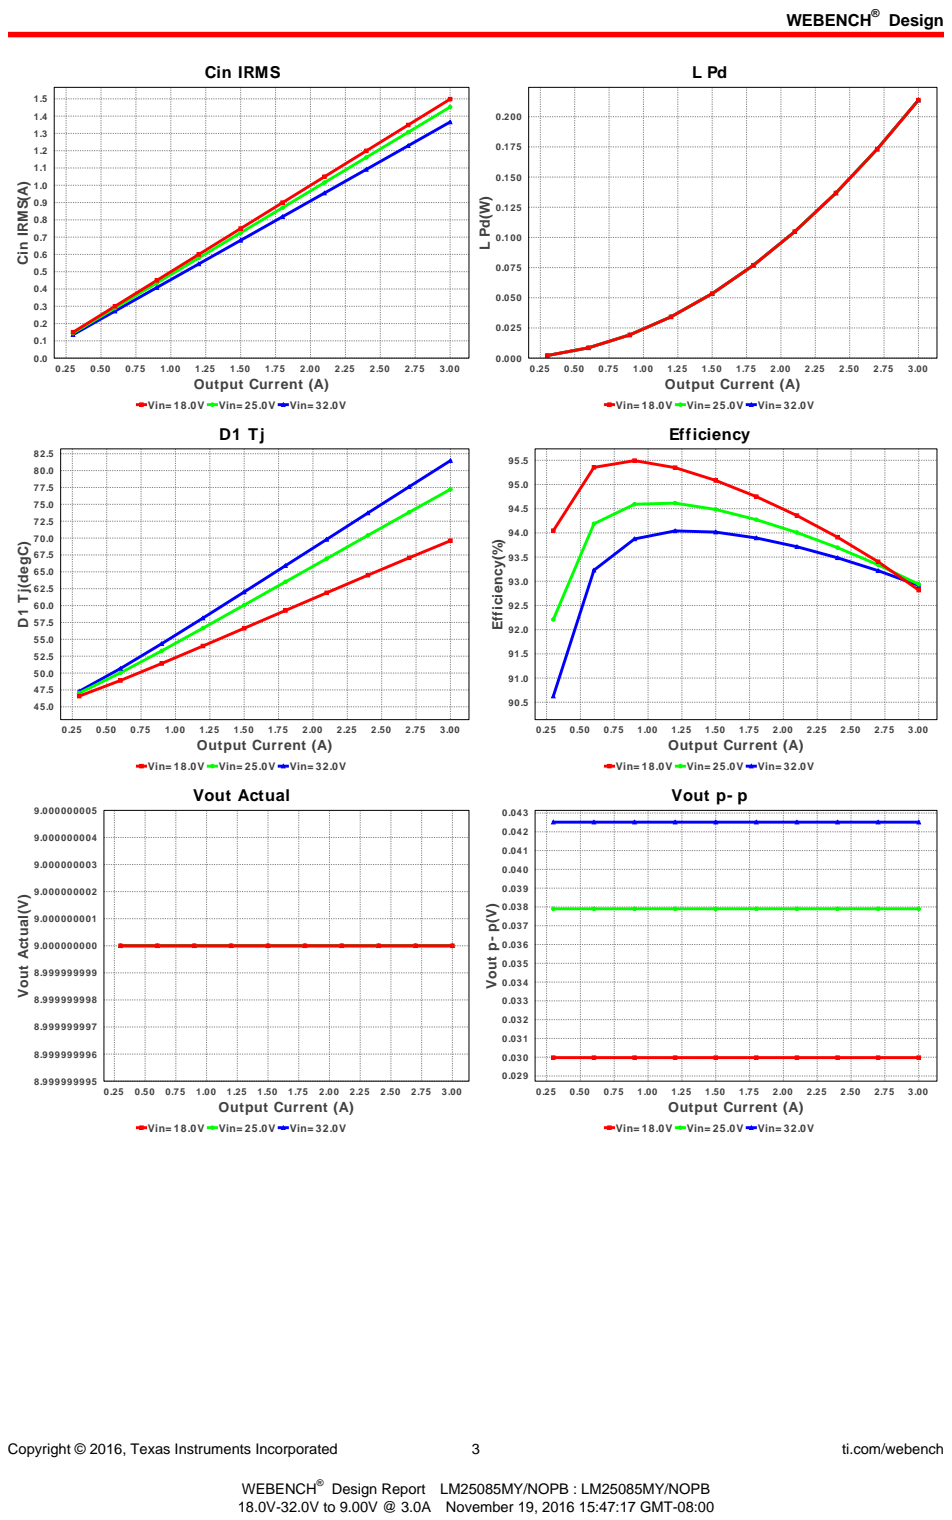
[picture p22: page 3]
Copyright © 2016, Texas Instruments Incorporated; ti.com/webench; Cin IRMS; 3.00 Output Current (A); Cin IRMS(A); D1 Tj(degC); Efficiency(%); 0.25 0.50 0.75 1.00 1.25 1.50 1.75 2.00 2.25 2.50 2.75 3.00 Output Current (A); Vout Actual(V); Vout p- p(V)

Vin= 18.0V Vin= 25.0V Vin= 32.0V

Efficiency

Vout Actual

Vout p- p

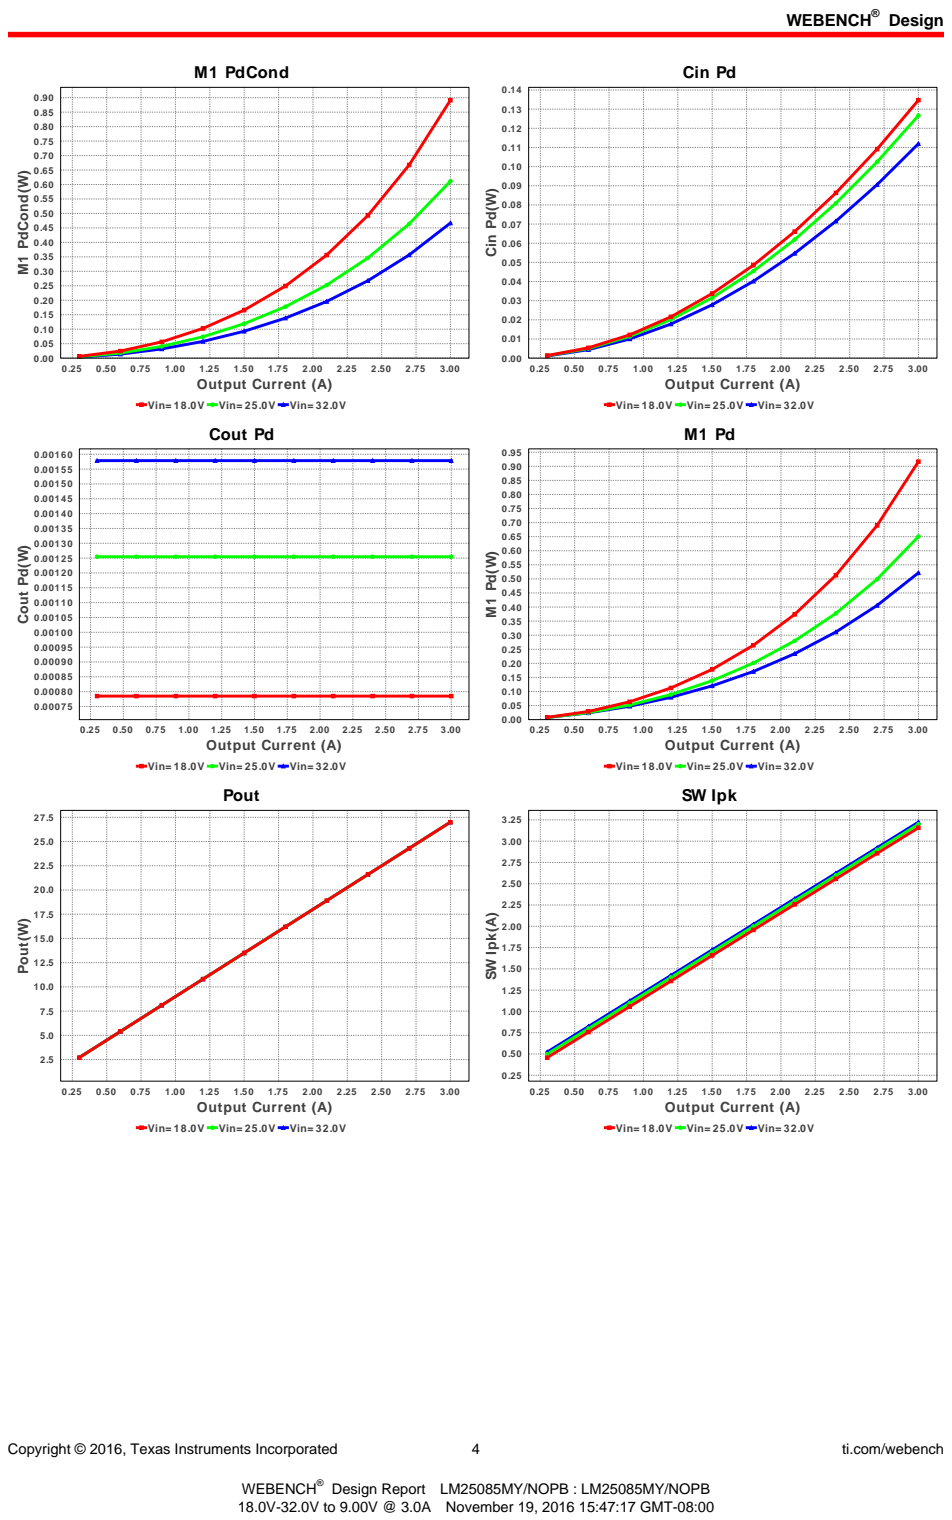
[picture p23: page 4]
Copyright © 2016, Texas Instruments Incorporated; ti.com/webench; M1 PdCond; 3.00 Output Current (A); M1 PdCond(W); Cin Pd; Cin Pd(W); Cout Pd; 0.25 0.50 0.75 1.00 1.25 1.50 1.75 2.00 2.25 2.50 2.75 3.00 Output Current (A); Cout Pd(W); Pout; Pout(W); SW Ipk; SW Ipk(A)

Vin= 18.0V Vin= 25.0V Vin= 32.0V

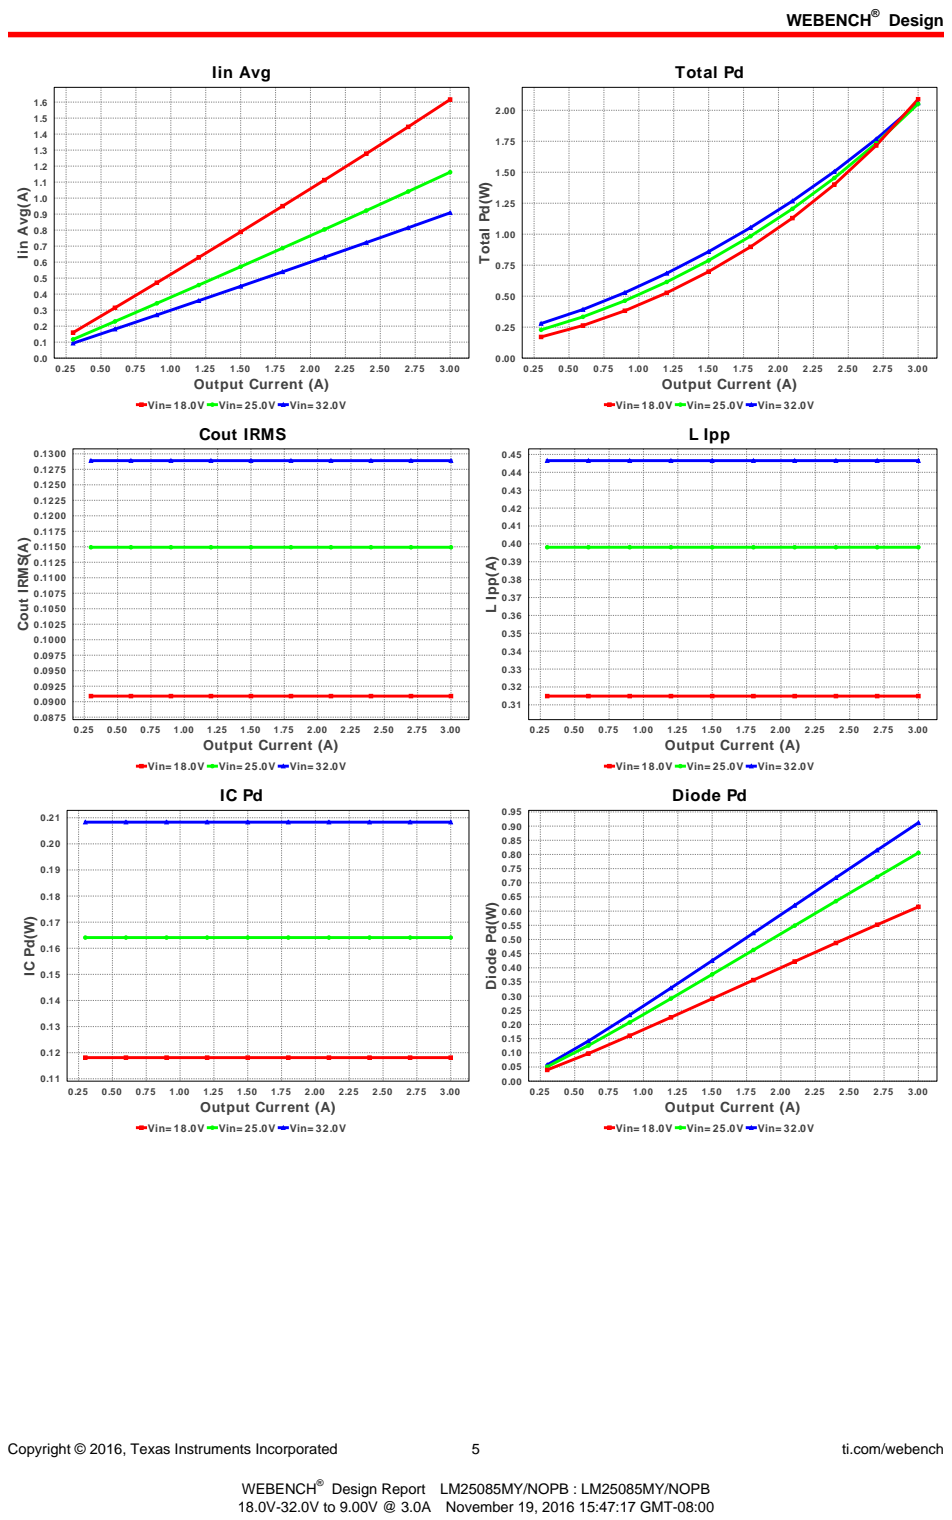
[picture p24: page 5]
Copyright © 2016, Texas Instruments Incorporated; ti.com/webench; Iin Avg; 3.00 Output Current (A); Iin Avg(A); Total Pd; Total Pd(W); Cout IRMS(A); L Ipp; L Ipp(A); Diode Pd(W)

Vin= 18.0V Vin= 25.0V Vin= 32.0V
Cout IRMS

Diode Pd

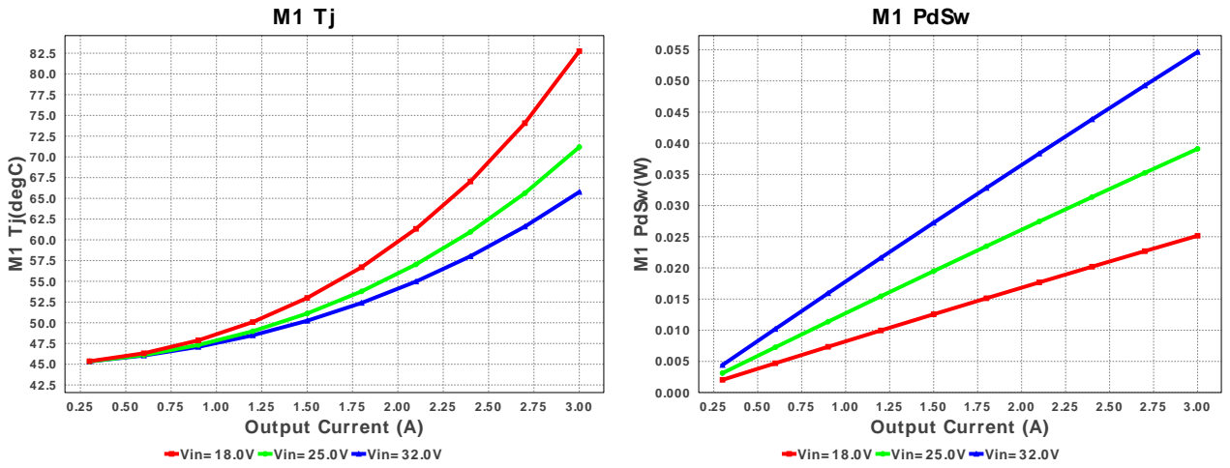
[picture p25: figure]
Vin= 18.0V Vin= 25.0V Vin= 32.0V; 3.00 Output Current (A); M1 Tj(degC); M1 PdSw; M1 PdSw(W)

Copyright © 2016, Texas Instruments Incorporated | 6 | ti.com/webench

## Operating Values

# | Name | Value | Category | Description

1. BOM Count | 15 | Total Design BOM count
2. Total BOM | $8.626 | Total BOM Cost
3. Cin IRMS | 1.366 A | Current | Input capacitor RMS ripple current
4. Cout IRMS | 128.903 mA | Current | Output capacitor RMS ripple current
5. Iin Avg | 908.1 mA | Current | Average input current
6. L Ipp | 446.534 mA | Current | Peak-to-peak inductor ripple current
7. SW Ipk | 3.223 A | Current | Peak switch current
8. FootPrint | 1.525 k mm² | General | Total Foot Print Area of BOM components
9. Frequency | 292.213 kHz | General | Switching frequency
10. IC Tolerance | 25.0 mV | General | IC Feedback Tolerance
11. Mode | CCM | General | Conduction Mode
12. Pout | 27.0 W | General | Total output power
13. D1 Tj | 81.476 degC | Op_Point | D1 junction temperature
14. Vout Actual | 9.0 V | Op_Point | Vout Actual calculated based on selected voltage divider resistors
15. Vout OP | 9.0 V | Op_Point | Operational Output Voltage
16. Duty Cycle | 29.338 % | Op_point | Duty cycle
17. Efficiency | 92.914 % | Op_point | Steady state efficiency
18. IC Tj | 54.582 degC | Op_point | IC junction temperature
19. ICThetaJA | 46.0 degC/W | Op_point | IC junction-to-ambient thermal resistance
20. IOUT_OP | 3.0 A | Op_point | Iout operating point
21. M1 Tj | 65.767 degC | Op_point | M1 MOSFET junction temperature
22. VIN_OP | 32.0 V | Op_point | Vin operating point
23. Vout p-p | 42.514 mV | Op_point | Peak-to-peak output ripple voltage
24. Cin Pd | 111.946 mW | Power | Input capacitor power dissipation
25. Cout Pd | 1.579 mW | Power | Output capacitor power dissipation
26. Diode Pd | 911.899 mW | Power | Diode power dissipation
27. IC Pd | 208.315 mW | Power | IC power dissipation
28. L Pd | 213.75 mW | Power | Inductor power dissipation
29. M1 Pd | 521.574 mW | Power | M1 MOSFET total power dissipation
30. M1 PdCond | 466.934 mW | Power | M1 MOSFET conduction losses
31. M1 PdSw | 54.64 mW | Power | M1 MOSFET switching losses
32. Total Pd | 2.059 W | Power | Total Power Dissipation
33. Vout Tolerance | 3.774 % | Vout Tolerance based on IC Tolerance (no load) and voltage divider
| | | | resistors if applicable

## Design Inputs

# | Name | Value | Description

1. Iout | 3.0 | Maximum Output Current
2. VinMax | 32.0 | Maximum input voltage
3. VinMin | 18.0 | Minimum input voltage
4. Vout | 9.0 | Output Voltage
5. base_pn | LM25085 | Base Product Number
6. source | DC | Input Source Type
7. Ta | 45.0 | Ambient temperature

## Design Assistance

1. For a Constant On Time device to be stable, we need to provide a ripple at the feedback comparator. There are various methods to implement the ripple. Depending on the circuit complexity vs. the allowable ripple, we have three options to choose from. The simplest option, 'Low Complexity', would require only a high ESR cap at the output. This means that the BOM count will be small, but the output voltage ripple

Copyright © 2016, Texas Instruments Incorporated | 7 | ti.com/webench

will be quite large. The 'optimal solution' would require a feed-forward cap in parallel with the upper feedback resistor to AC couple the ripple to the feedback node. This increases the BOM count slightly, but now we have more control over the output voltage ripple. If the output voltage requirement is very tight, then the best option is to go for the 'Low Output Ripple' solution. In this option we can go with very low ESR output caps and have very good control over the output voltage ripple
2. LM25085 Product Folder : http://www.ti.com/product/LM25085 : contains the data sheet and other resources.

Texas Instruments' WEBENCH simulation tools attempt to recreate the performance of a substantially equivalent physical implementation
of the design. Simulations are created using Texas Instruments' published specifications as well as the published specifications of other device manufacturers. While Texas Instruments does update this information periodically, this information may not be current at the time the simulation is built. Texas Instruments does not warrant the accuracy or completeness of the specifications or any information contained therein. Texas Instruments does not warrant that any designs or recommended parts will meet the specifications you entered, will be suitable for your application or fit for any particular purpose, or will operate as shown in the simulation in a physical implementation. Texas Instruments does not warrant that the designs are production worthy.
You should completely validate and test your design implementation to confirm the system functionality for your application prior to production.
Use of Texas Instruments' WEBENCH simulation tools is subject to Texas Instruments' Site Terms and Conditions of Use. (http://www.ti.com/corp/docs/legal/termsofuse.shtml) Prototype boards based on WEBENCH created designs are provided AS IS without warranty of any kind for evaluation and testing purposes and are subject to the terms of the Evaluation License Agreement. (http://www.ti.com/corp/docs/legal/termsofuse_estore.shtml)
