wykys/BNEZ-projekt/dokumentace/img/LM317.pdf

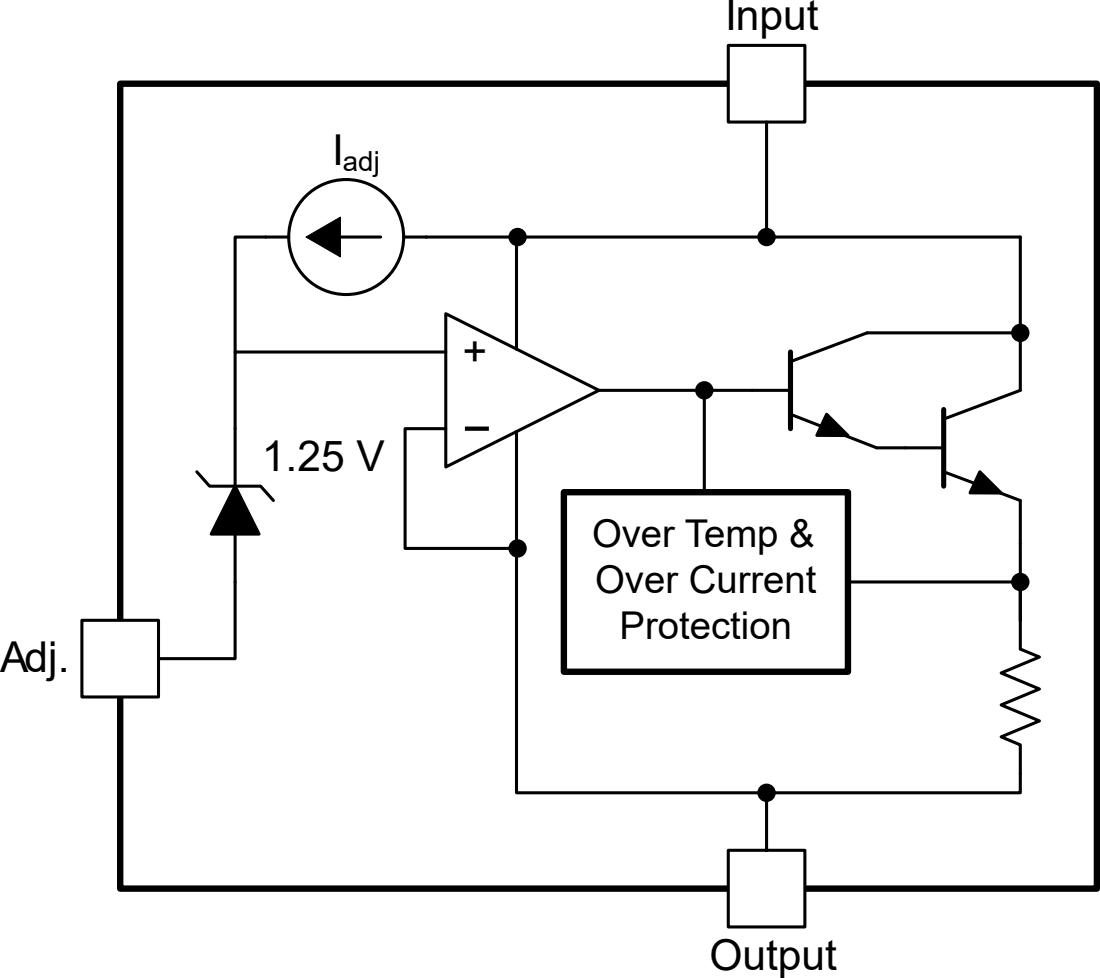
[picture p28: page 1]
Over Temp & Over Current Protection; Input; Adj.; Output; Iadj
