wykys/BNEZ-projekt/dokumentace/img/LM317_sch.pdf

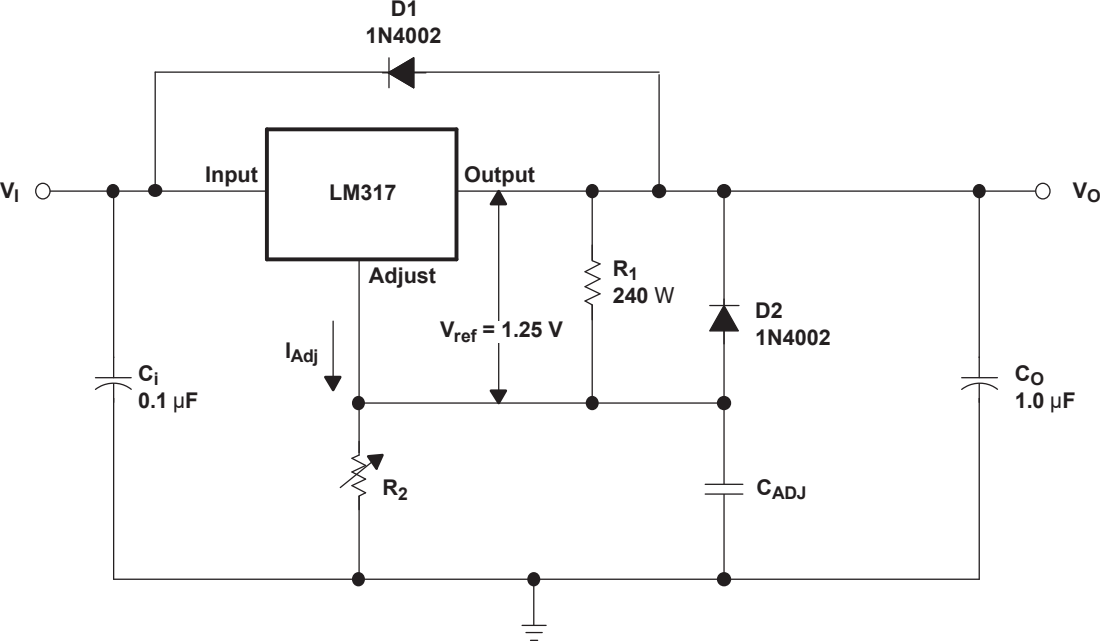
[picture p29: page 1]
IAdj; Adjust; Input; Output; Vref = 1.25 V; CADJ
