wykys/BNEZ-projekt/design/xvykyd06_zdroj.pdf

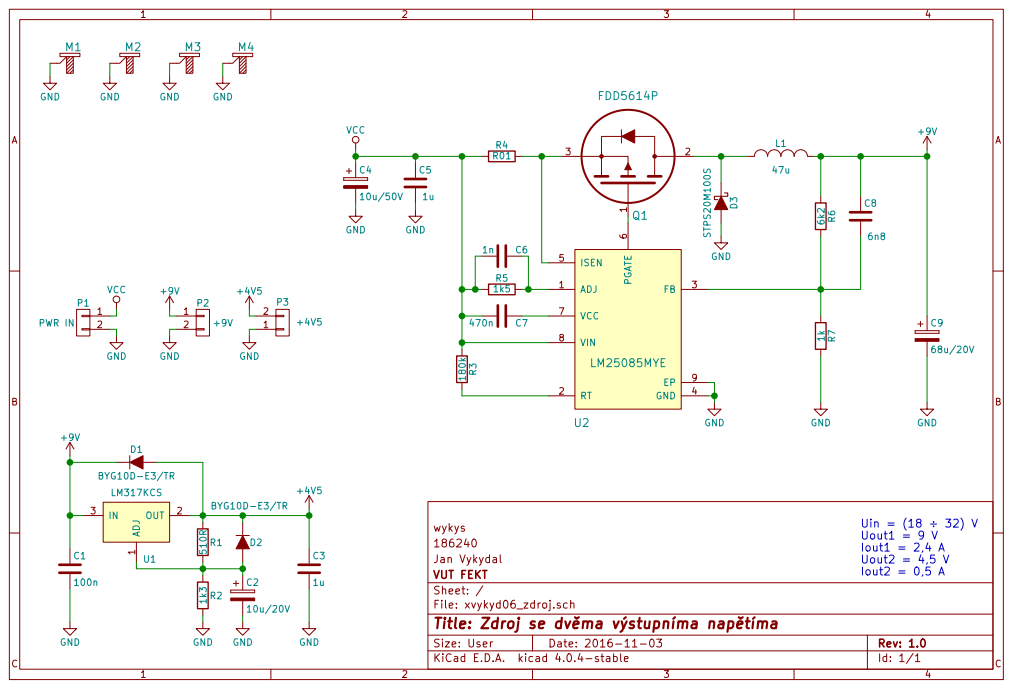
[picture p30: page 1]

File: xvykyd06_zdroj.sch Sheet: / VUT FEKT

Id: 1/1 Title: Zdroj se dvma výstupníma naptíma
