wykys/BNEZ-projekt/design/PDF_out/bot.pdf

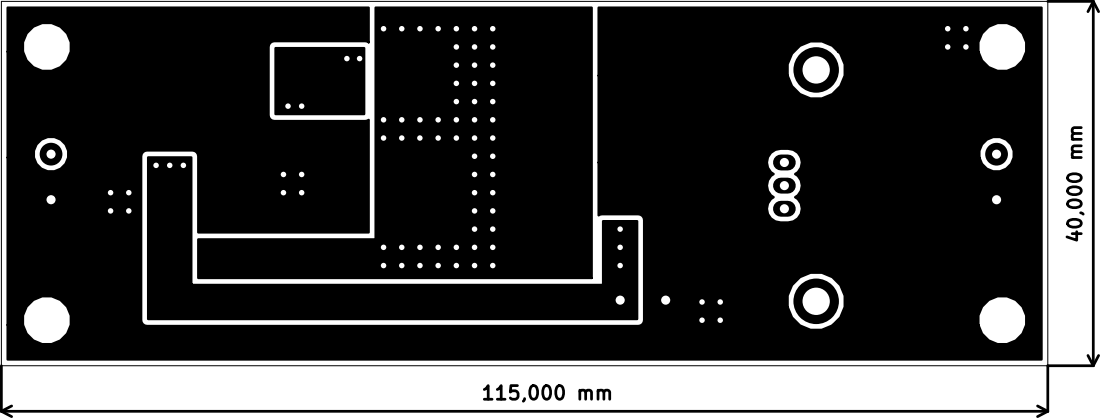
[picture p31: page 1]
