wykys/BNEZ-projekt/design/PDF_out/osazovak.pdf

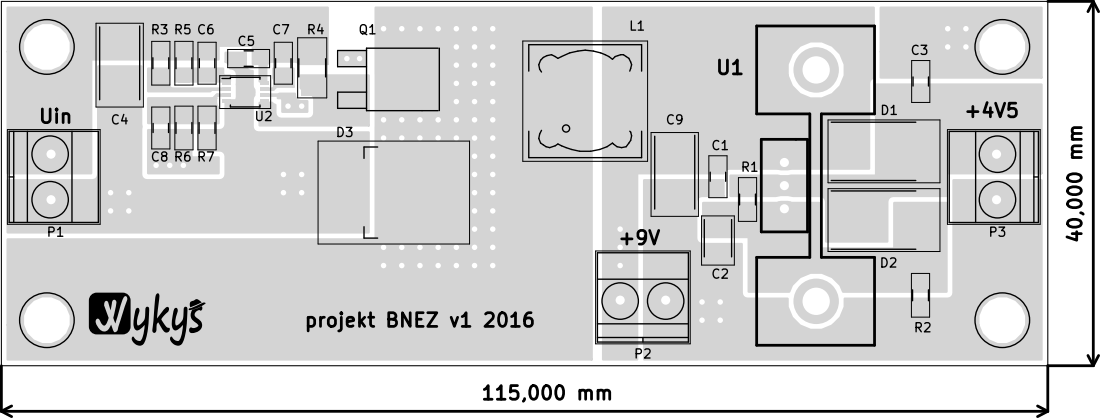
[picture p32: page 1]
