wykys/BNEZ-projekt/design/PDF_out/prokov.pdf

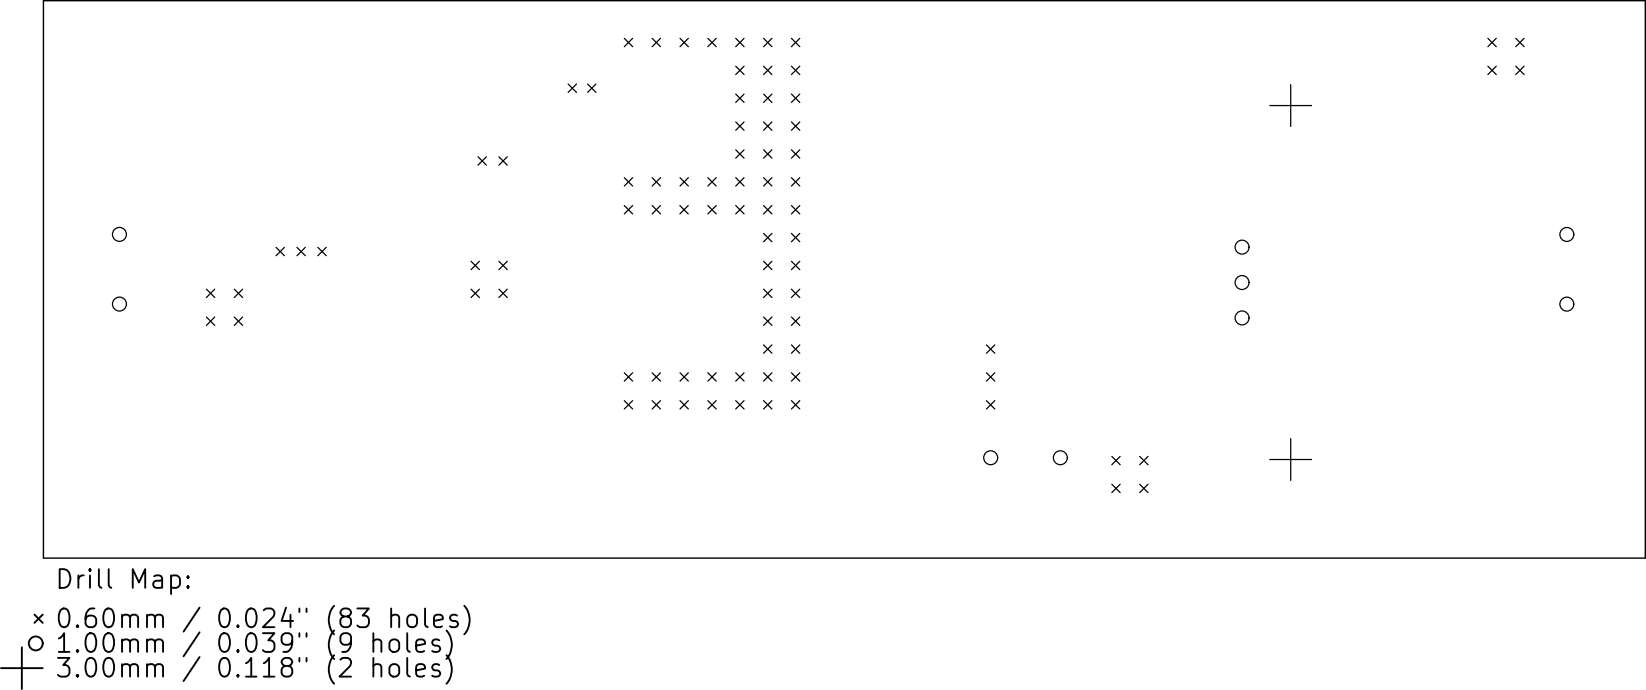
[picture p33: page 1]
