wykys/BNEZ-projekt/design/PDF_out/prokov_ne.pdf

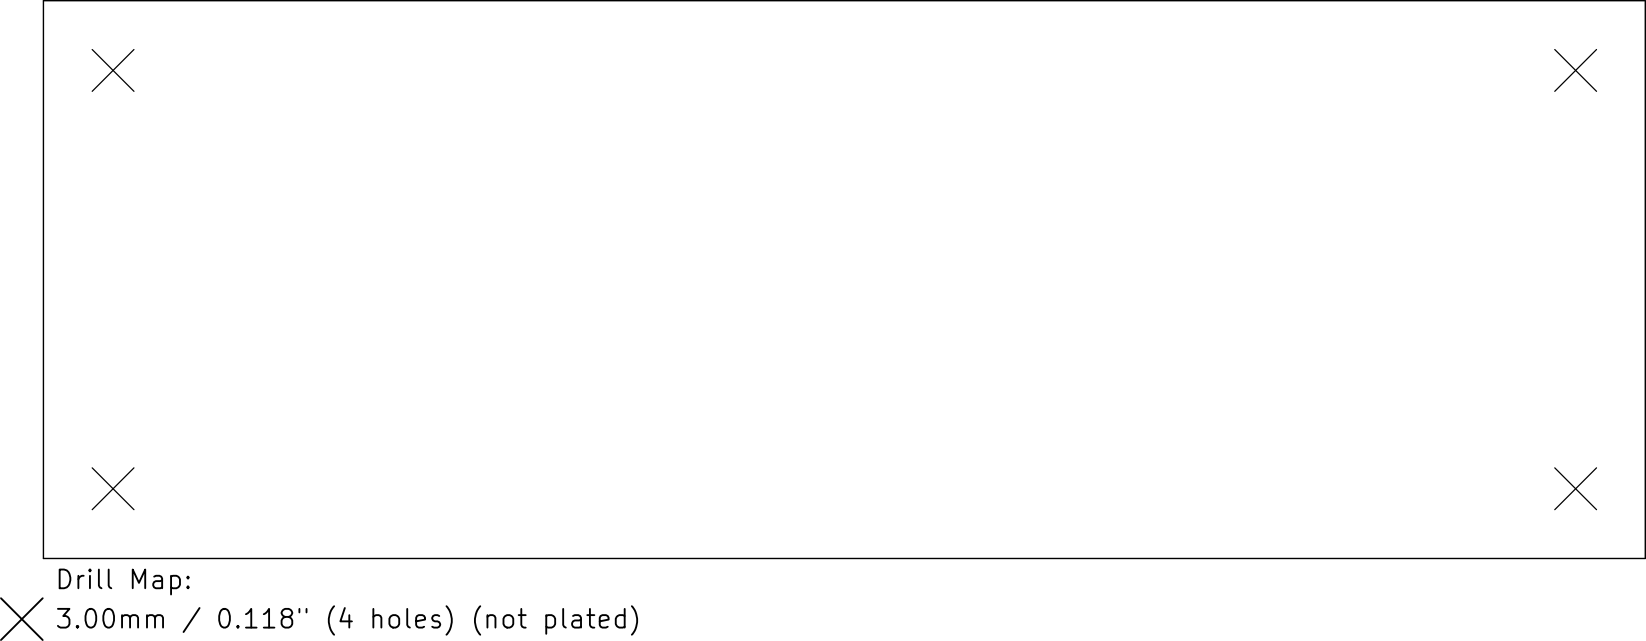
[picture p34: page 1]
