wykys/BNEZ-projekt/design/PDF_out/top.pdf

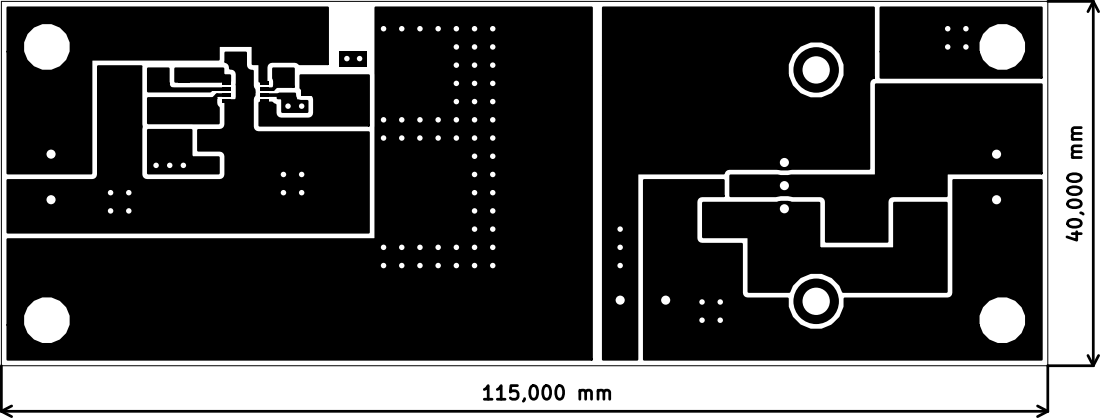
[picture p35: page 1]
