wykys/BNEZ-projekt/(list of files, drawings)

Other design files:
sim/BNEZ.dsn
sim/BNEZ.opj
sim/LM25085_TRANS.DSN
sim/LM25085_TRANS.OLB
sim/LM25085_TRANS.opj
