wykys/BNEZ-projekt/design/xvykyd06_zdroj.kicad_pcb

## KiCad design design/xvykyd06_zdroj.kicad_pcb (2016-11-27)

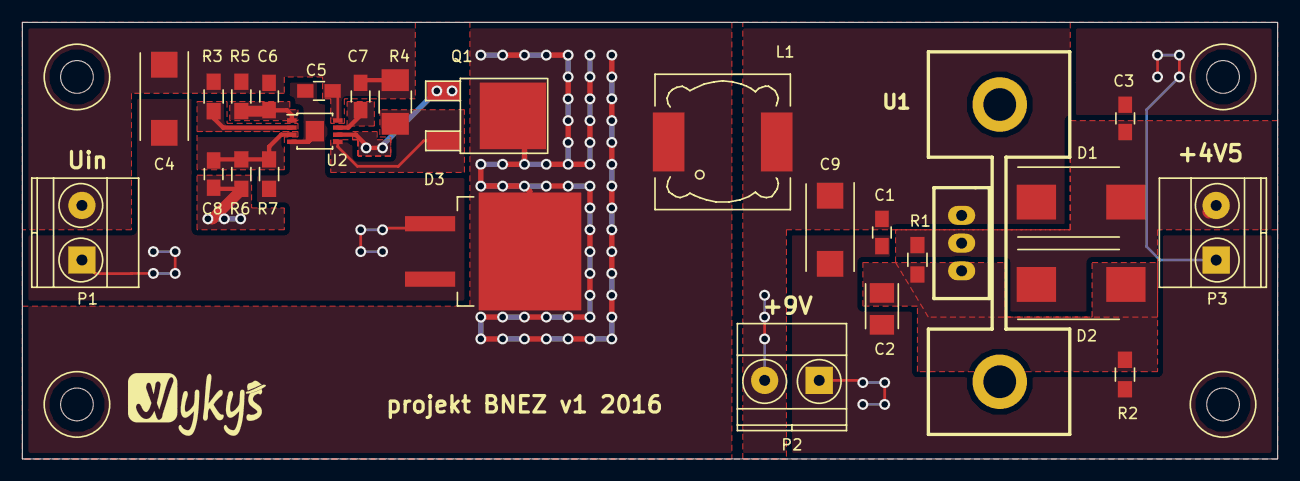
[picture p36: board xvykyd06_zdroj.kicad_pcb from above]

Board: 2 copper layers, 115.0 x 40.0 mm, 30 parts (0 on the bottom side), 12 nets.

Parts:
C1: 100n; C_0805_HandSoldering
C2: 10u/20V; TantalC_SizeB_EIA-3528_Reflow
C3, C5: 1u; C_0805_HandSoldering
C4: 10u/50V; TantalC_SizeD_EIA-7343_Reflow
C6: 1n; C_0805_HandSoldering
C7: 470n; C_0805_HandSoldering
C8: 6n8; C_0805_HandSoldering
C9: 68u/20V; TantalC_SizeD_EIA-7343_Reflow
D1, D2: BYG10D-E3/TR; DO-214AB_Handsoldering
D3: STPS20M100S; TO-263-3Lead
L1: 47u; Choke_SMD_12x12mm_h6mm
M1, M2, M3, M4: M3
P1: PWR IN; TerminalBlock_Pheonix_MKDS1.5-2pol
P2: +9V; TerminalBlock_Pheonix_MKDS1.5-2pol
P3: +4V5; TerminalBlock_Pheonix_MKDS1.5-2pol
Q1: FDD5614P; TO-252-2Lead
R1: 510R; R_0805_HandSoldering
R2: 1k3; R_0805_HandSoldering
R3: 180k; R_0805_HandSoldering
R4: R01; R_1210_HandSoldering
R5: 1k5; R_0805_HandSoldering
R6: 6k2; R_0805_HandSoldering
R7: 1k; R_0805_HandSoldering
U1: LM317KCS; to220_std_11cw
U2: LM25085MYE; MSOP-8-1EP_3x3mm_Pitch0.65mm

Connections:
+4V5: C3.1, D1.2, D2.1, P3.2, R1.1, U1.2
+9V: C1.1, C8.1, C9.1, D1.1, L1.2, P2.1, R6.1, U1.3
GND: C1.2, C2.2, C3.2, C4.2, C5.2, C9.2, D3.2, P1.2, P2.2, P3.1, R2.2, R7.2, U2.4, U2.9
unnamed: C2.1, D2.2, R1.2, R2.1, U1.1
unnamed: C6.1, R5.2, U2.1
unnamed: C7.1, U2.7
unnamed: C8.2, R6.2, R7.1, U2.3
unnamed: D3.1, L1.1, Q1.2
unnamed: Q1.1, U2.6
unnamed: Q1.3, R4.2, U2.5
unnamed: R3.2, U2.2
VCC: C4.1, C5.1, C6.2, C7.2, P1.1, R3.1, R4.1, R5.1, U2.8
